cGooding66/cLib/Freecad/Furrel-Green.png

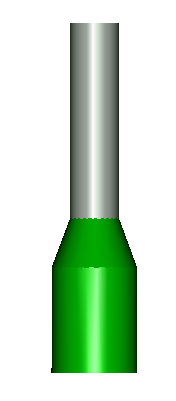
Freecad/Furrel-Green.png
