cGooding66/cLib/3d/D0008A_ASM_cp.step

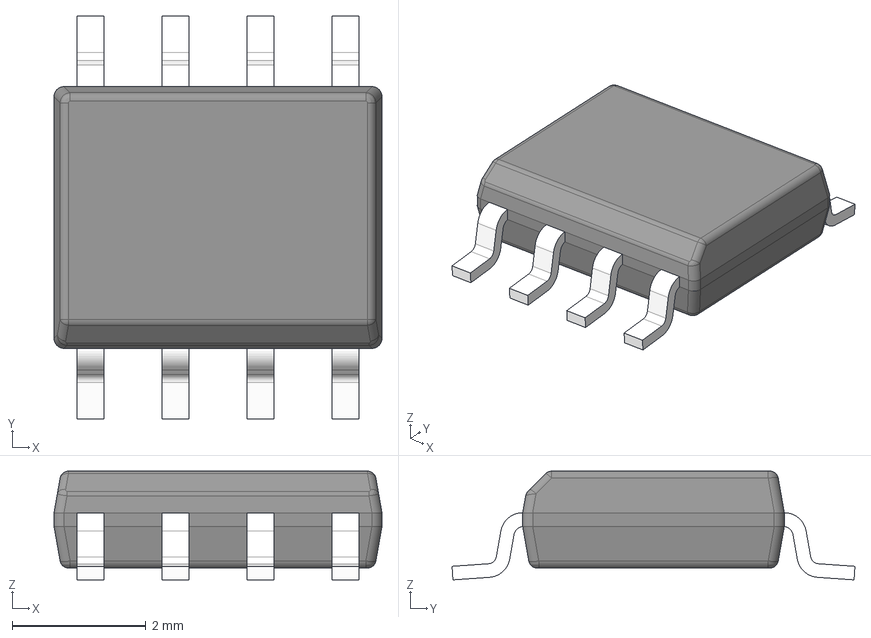
[picture p3: CAD file, 2018-07-28]
3d/D0008A_ASM_cp.step
4.90 x 6.02 x 1.63 mm
