cGooding66/cLib/3d/DBV0006A_ASM_cp.step

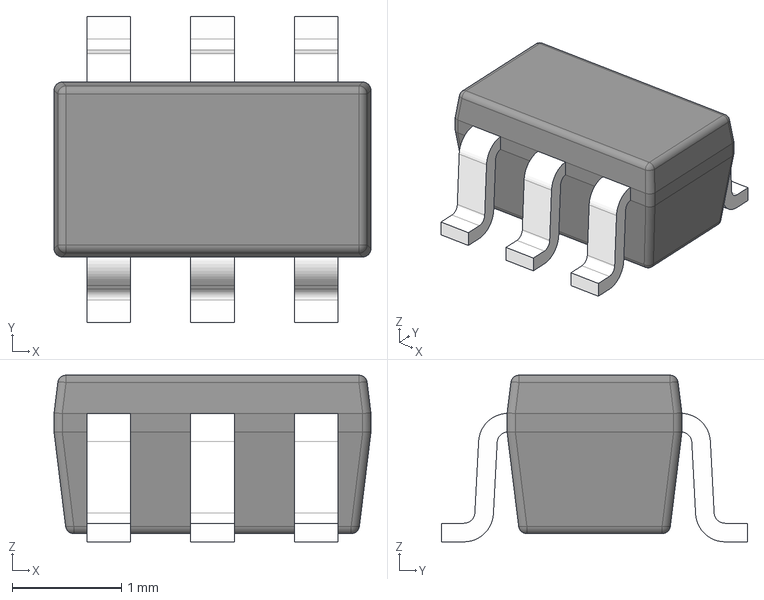
[picture p4: CAD file, 2018-07-28]
3d/DBV0006A_ASM_cp.step
2.90 x 2.80 x 1.53 mm
