cGooding66/cLib/3d/RSE0008A_ASM_cp.step

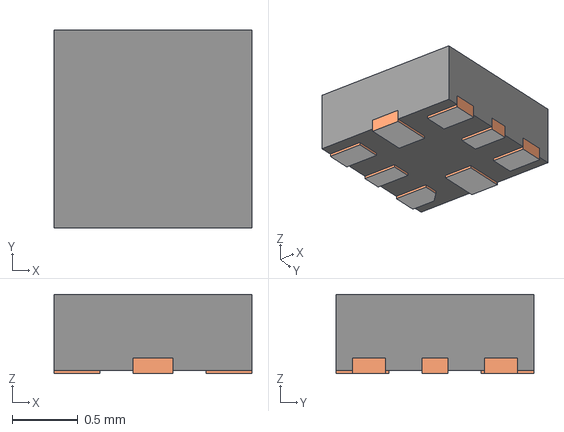
[picture p5: CAD file, 2018-07-28]
3d/RSE0008A_ASM_cp.step
1.50 x 1.50 x 0.6 mm
