cGooding66/cLib/3d/HSON8.step

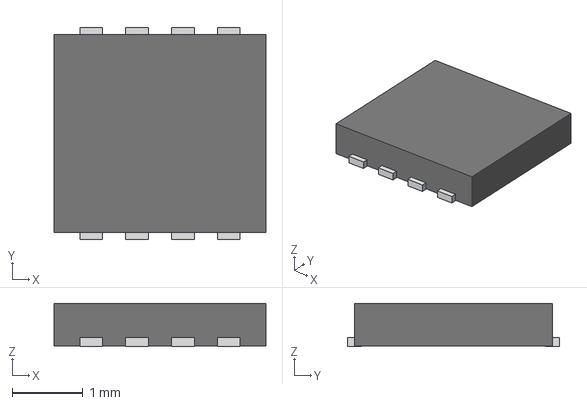
[picture p6: CAD file, 2018-07-28]
3d/HSON8.step
3.00 x 3.00 x 0.61 mm
