cGooding66/cLib/Freecad/Ferrule-Red.step

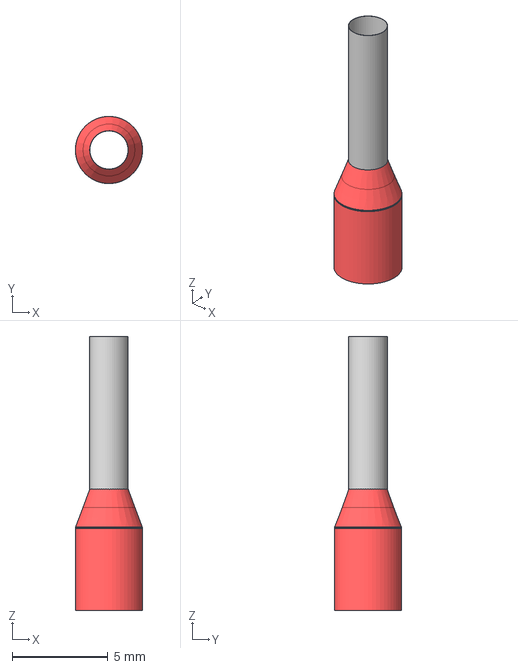
[picture p7: CAD file, 2018-07-28]
Freecad/Ferrule-Red.step
3.51 x 3.51 x 14.3 mm
