cGooding66/cLib/3d/DCJ200-10-A-K1-K.step

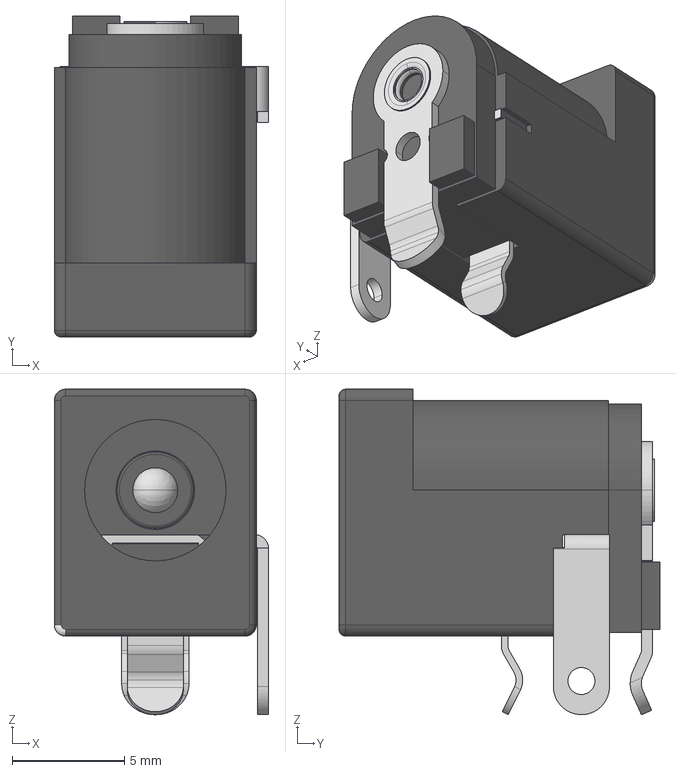
[picture p8: CAD file, 2018-07-28]
3d/DCJ200-10-A-K1-K.step
9.55 x 14.3 x 14.5 mm
