cGooding66/cLib/3d/DO219AB.step

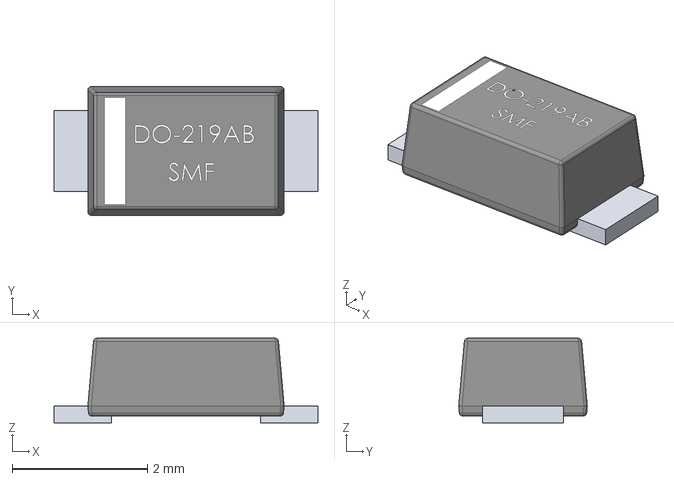
[picture p9: CAD file, 2018-07-28]
3d/DO219AB.step
3.90 x 1.90 x 1.25 mm
