cGooding66/cLib/Freecad/Amber-LED.fcstd

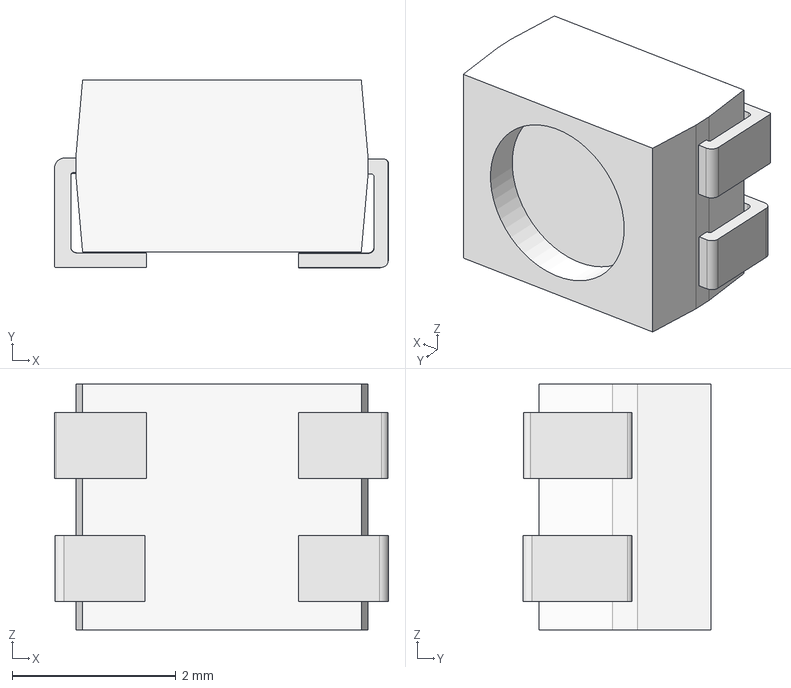
[picture p10: CAD file, 2018-07-28]
Freecad/Amber-LED.fcstd
4.07 x 2.29 x 3.00 mm
