cGooding66/cLib/3d/QSOP16-1.step

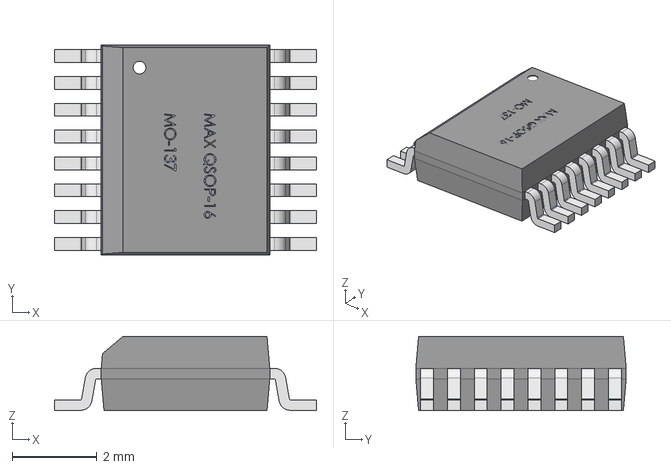
[picture p11: CAD file, 2018-07-28]
3d/QSOP16-1.step
6.20 x 4.98 x 1.76 mm
