cGooding66/cLib/Freecad/LED-PLCC4.stp

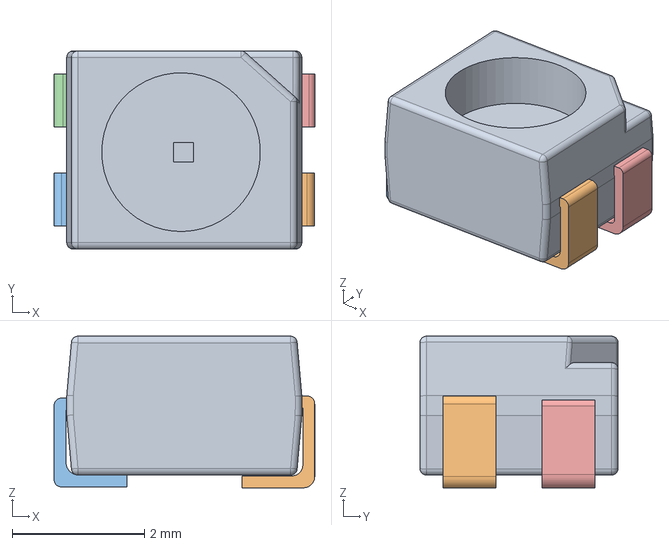
[picture p12: CAD file, 2018-07-28]
Freecad/LED-PLCC4.stp
3.95 x 3.00 x 2.29 mm
