cGooding66/cLib/3d/TQFP_48.step

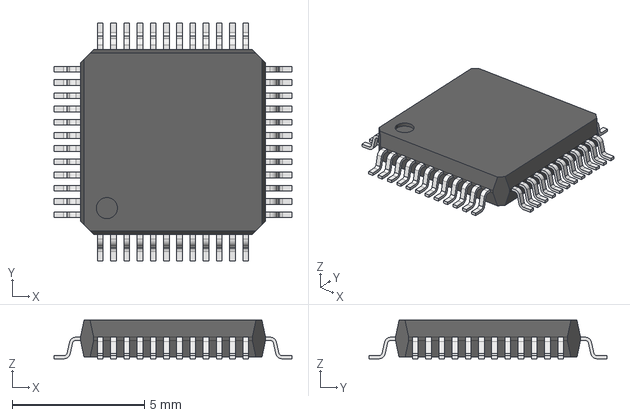
[picture p13: CAD file, 2018-07-28]
3d/TQFP_48.step
9.00 x 9.00 x 1.46 mm
