cGooding66/cLib/3d/mcv_1.5-8-gf-3.5.step

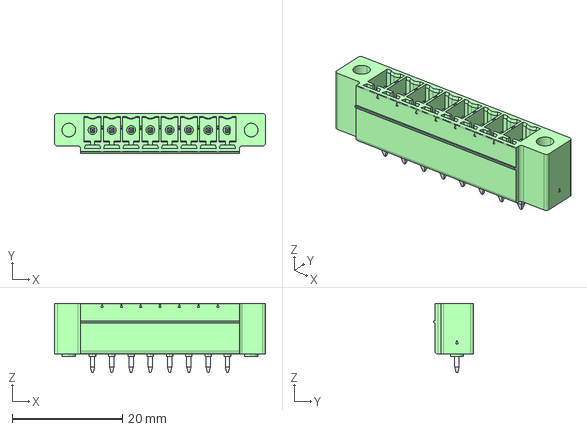
[picture p14: CAD file, 2018-07-28]
3d/mcv_1.5-8-gf-3.5.step
38.3 x 7.25 x 12.6 mm
