cGooding66/cLib/Freecad/Cable.fcstd

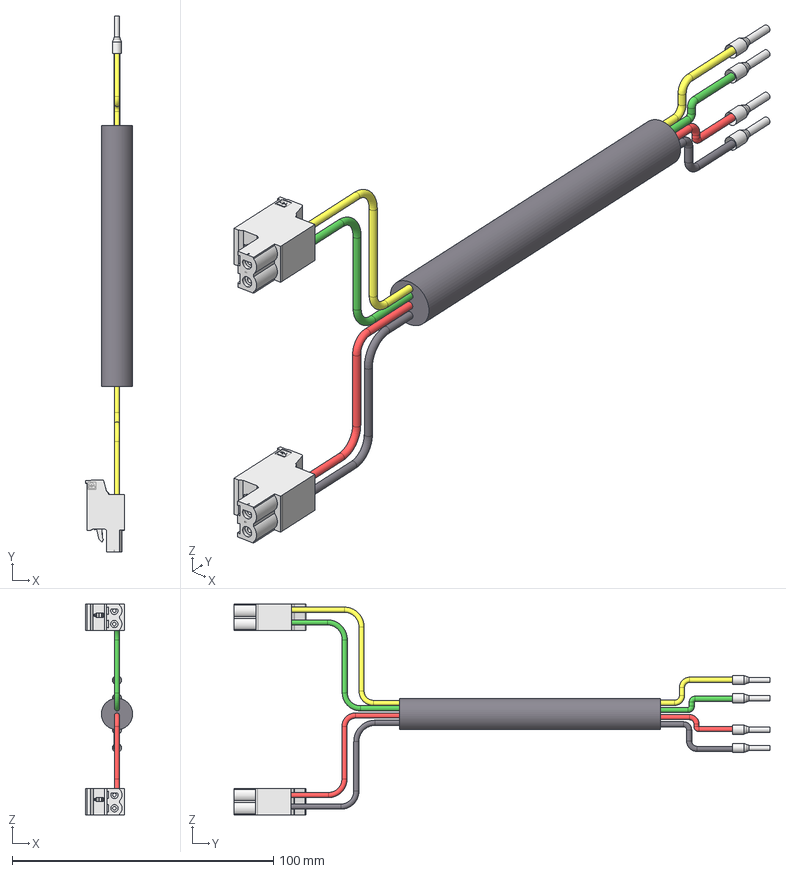
[picture p16: CAD file, 2018-07-28]
Freecad/Cable.fcstd
18.1 x 205.2 x 80.7 mm
Cable
Phoenix
Black-Ferrule
Green-Ferrule
Red-Ferrule
Yellow-Ferrule
Phoenix001
