cGooding66/cLib/Freecad/Ferrule.fcstd

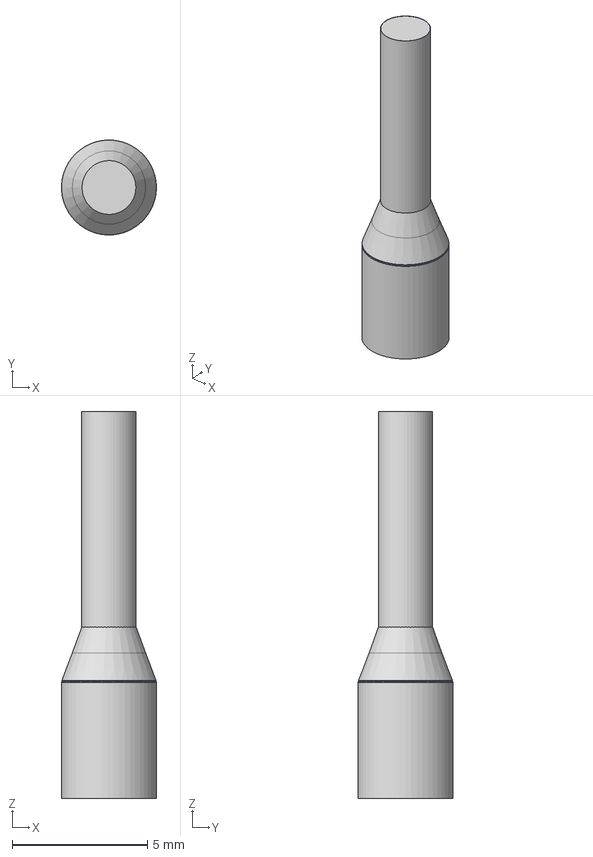
[picture p17: CAD file, 2018-07-28]
Freecad/Ferrule.fcstd
3.51 x 3.51 x 14.3 mm
