cGooding66/cLib/3d/VHR-2N.STEP

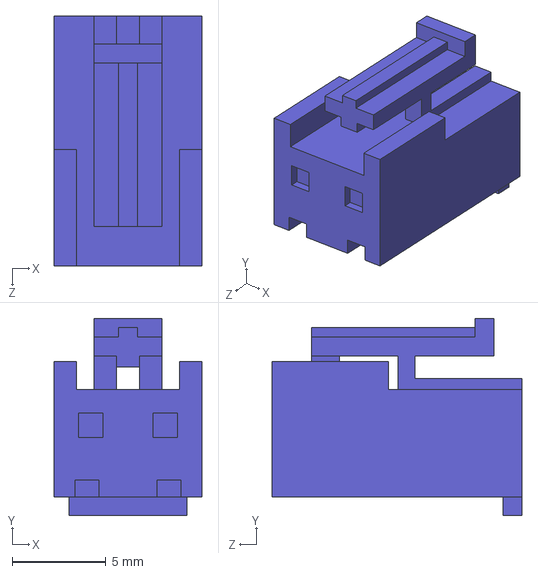
[picture p18: CAD file, 2018-07-28]
3d/VHR-2N.STEP
7.86 x 10.5 x 13.3 mm
