cGooding66/cLib/3d/9GTH935.step

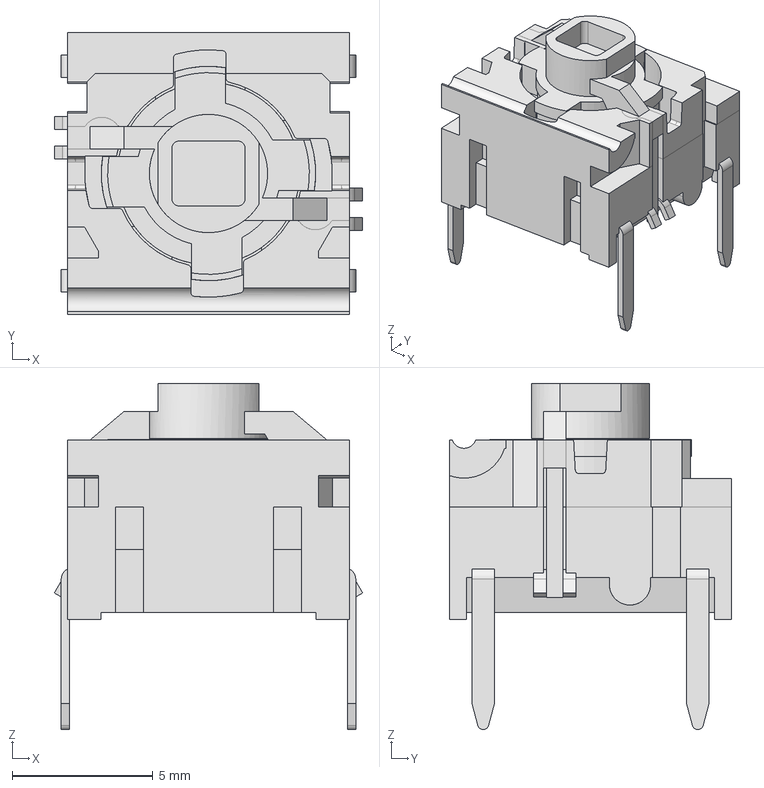
[picture p19: CAD file, 2018-07-28]
3d/9GTH935.step
10.9 x 10.0 x 12.3 mm
