cGooding66/cLib/3d/LED_RED_PLCC4.step

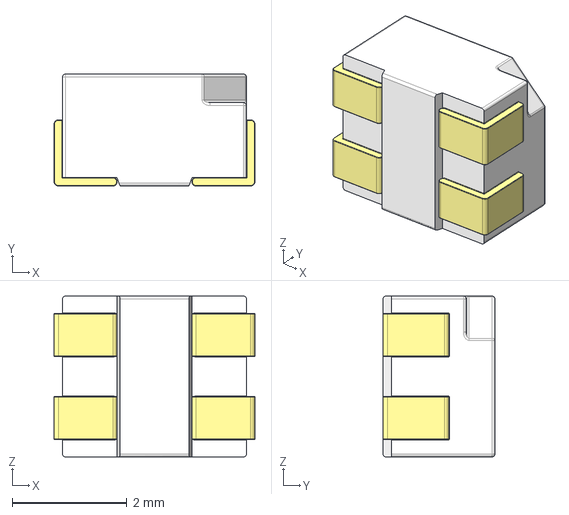
[picture p20: CAD file, 2018-07-28]
3d/LED_RED_PLCC4.step
3.50 x 1.95 x 2.80 mm
