cGooding66/cLib/3d/User Library-tsx-3225-1.stl

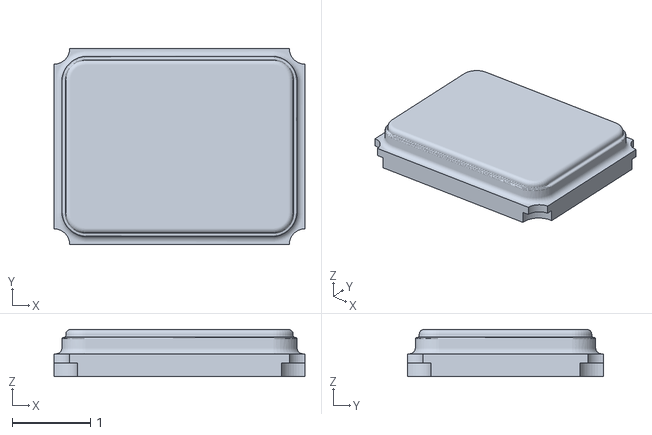
[picture p21: CAD file, 2018-07-28]
3d/User Library-tsx-3225-1.stl
3.20 x 2.50 x 0.6
