cGooding66/cLib/3d/EEEFKC151XAP.step

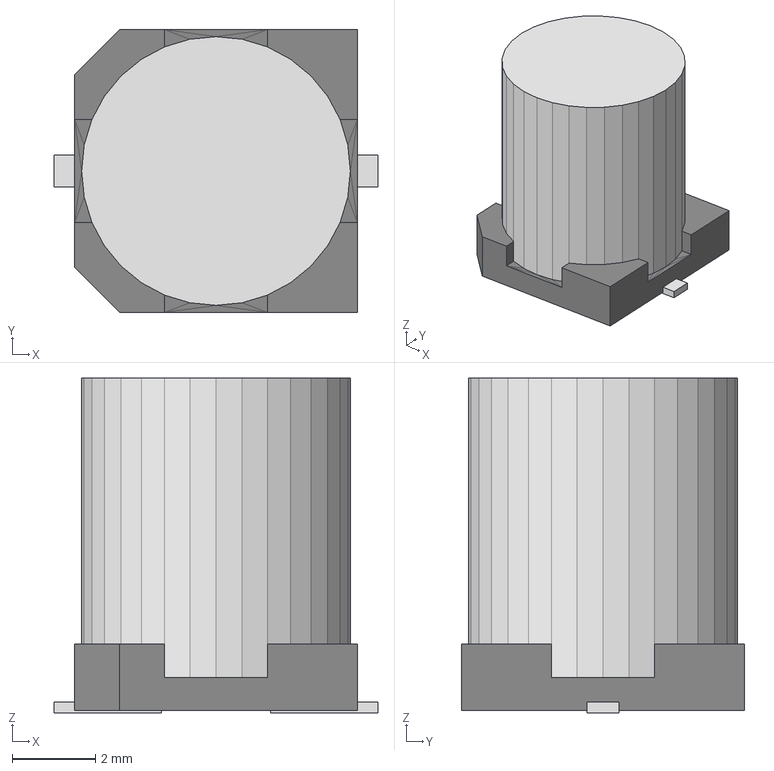
[picture p22: CAD file, 2018-07-28]
3d/EEEFKC151XAP.step
7.80 x 6.81 x 8.05 mm
