cGooding66/cLib/3d/ABS07.step

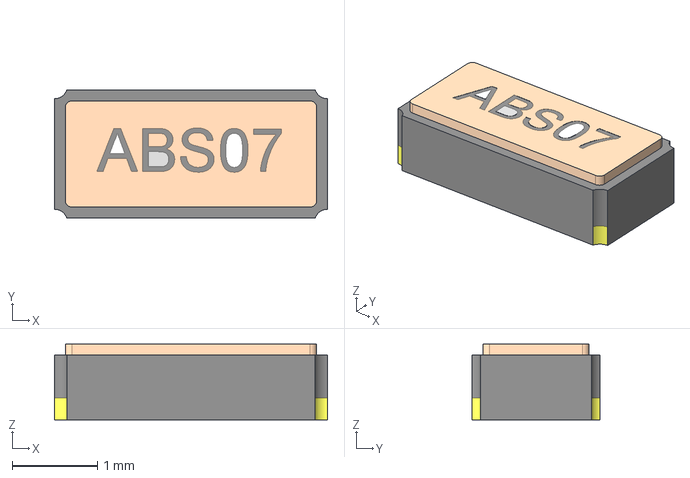
[picture p23: CAD file, 2018-07-28]
3d/ABS07.step
3.20 x 1.50 x 0.889 mm
