cGooding66/cLib/3d/DIODE_SMA.step

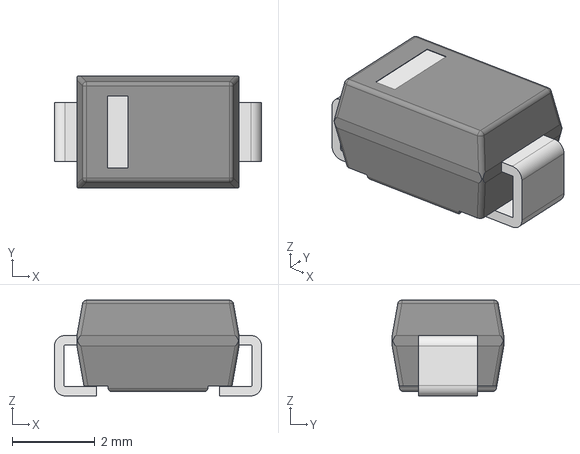
[picture p24: CAD file, 2018-07-28]
3d/DIODE_SMA.step
5.00 x 2.70 x 2.31 mm
