cGooding66/cLib/3d/B3B-PH-K-S.step

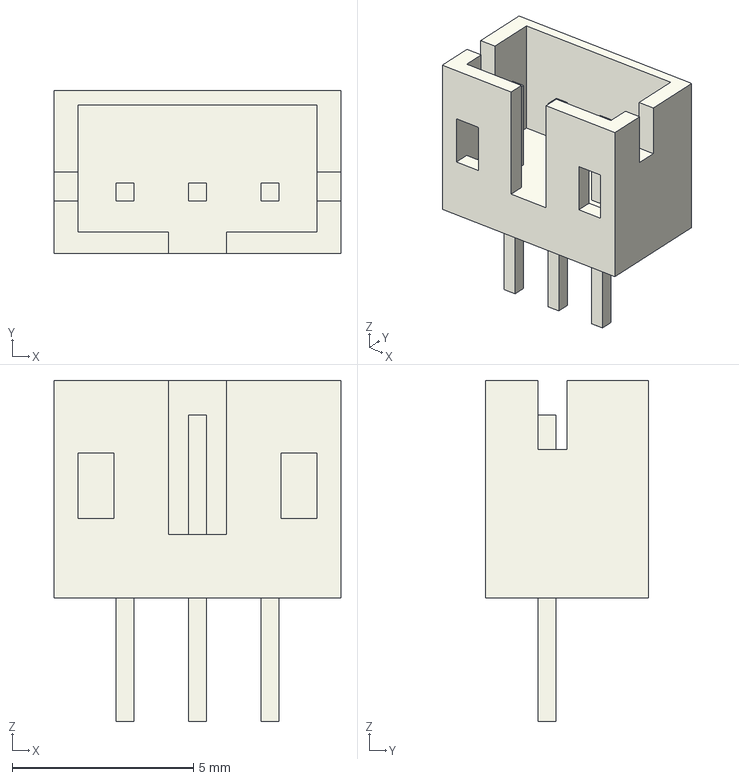
[picture p25: CAD file, 2018-07-28]
3d/B3B-PH-K-S.step
7.90 x 4.50 x 9.40 mm
