cGooding66/cLib/3d/User Library-TSSOP20.stl

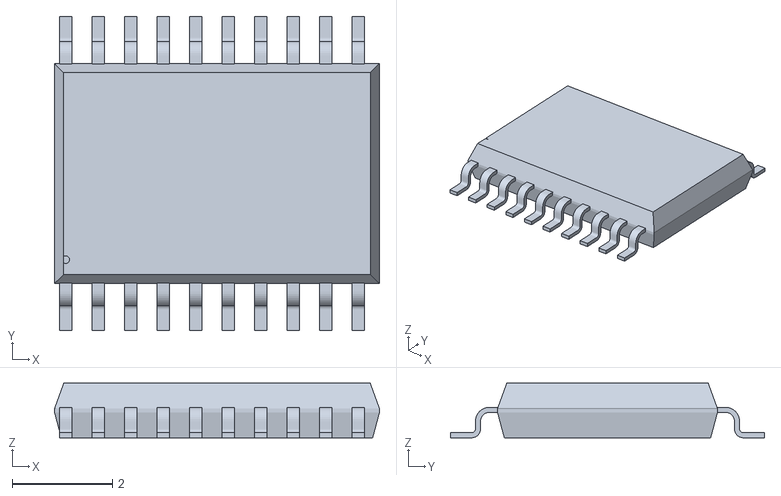
[picture p26: CAD file, 2018-07-28]
3d/User Library-TSSOP20.stl
6.50 x 6.28 x 1.09
