cGooding66/cLib/3d/QFN24.step

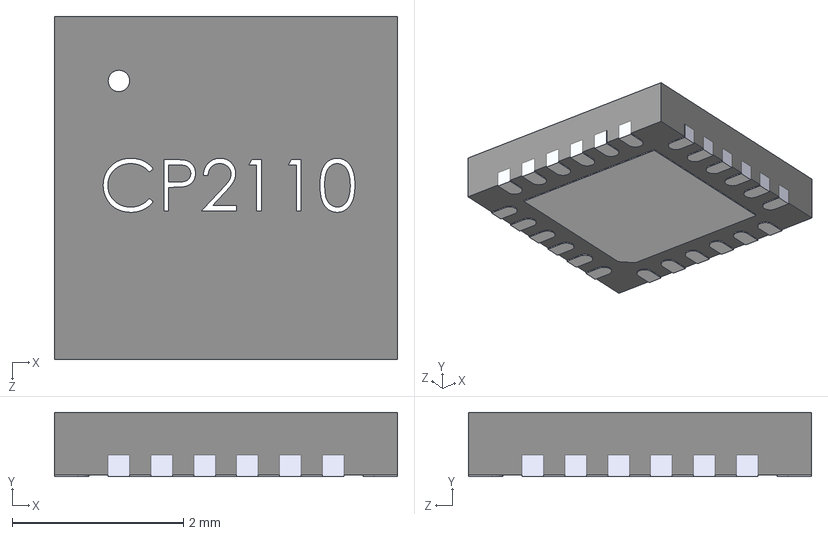
[picture p27: CAD file, 2018-07-28]
3d/QFN24.step
4.00 x 0.75 x 4.00 mm
