cGooding66/cLib/3d/B2P-VH-B.STEP

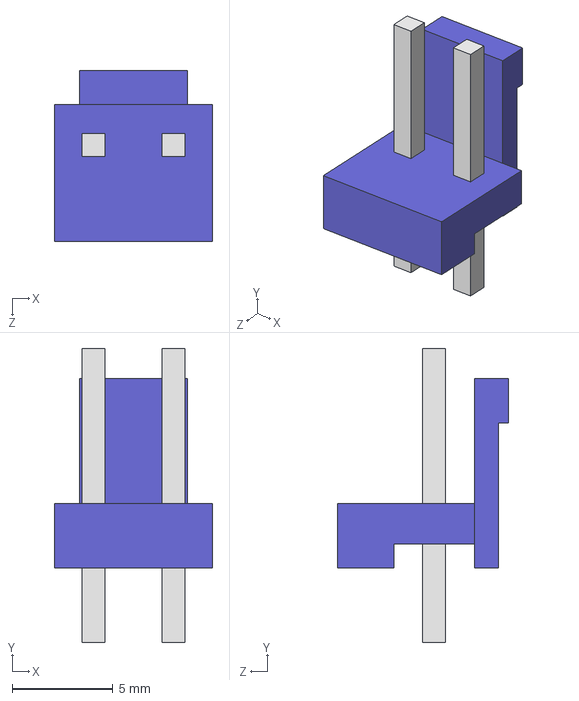
[picture p28: CAD file, 2018-07-28]
3d/B2P-VH-B.STEP
7.86 x 14.6 x 8.50 mm
