cGooding66/cLib/3d/mcv_1.5-5-gf-3.5.step

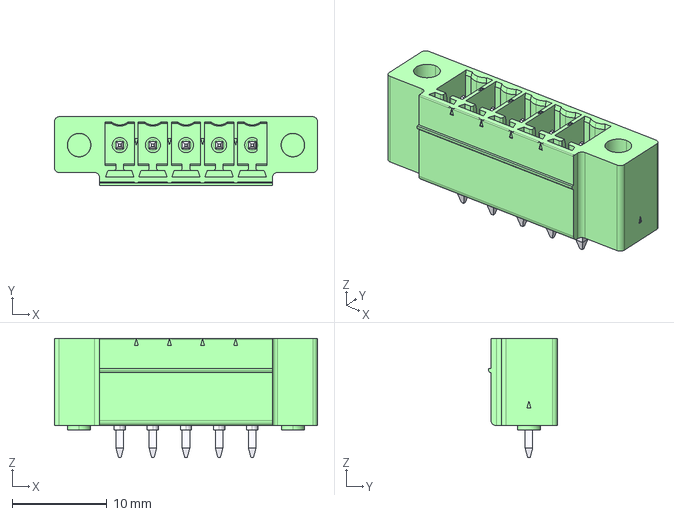
[picture p29: CAD file, 2018-07-28]
3d/mcv_1.5-5-gf-3.5.step
27.8 x 7.25 x 12.6 mm
