cGooding66/cLib/3d/TSW-110-14-L-D-LL.step

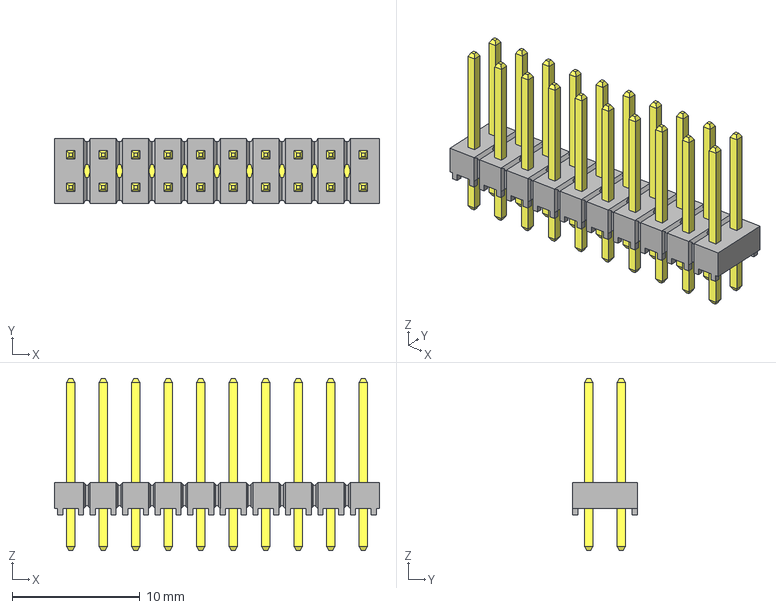
[picture p30: CAD file, 2018-07-28]
3d/TSW-110-14-L-D-LL.step
25.4 x 5.08 x 13.5 mm
