cGooding66/cLib/3d/SRN6045_Series.step

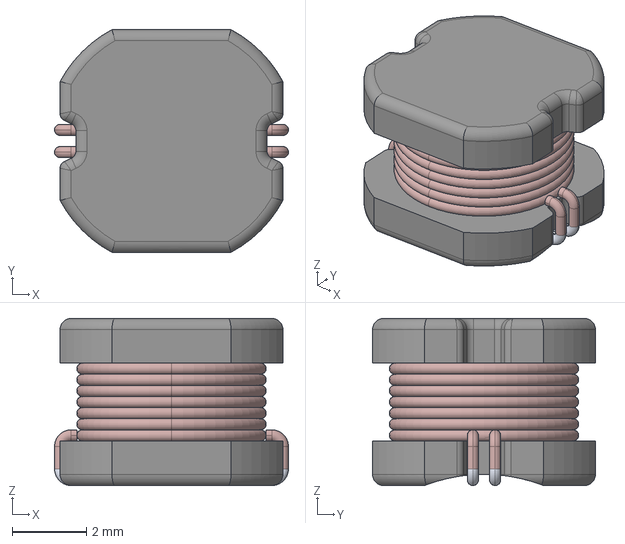
[picture p31: CAD file, 2018-07-28]
3d/SRN6045_Series.step
6.30 x 6.00 x 4.50 mm
