cGooding66/cLib/3d/SM08B-NSHSS.step

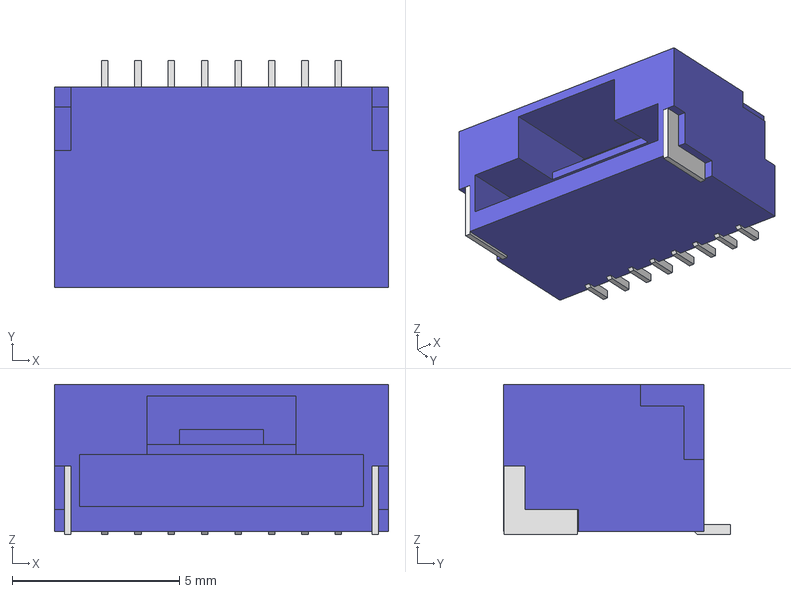
[picture p32: CAD file, 2018-07-28]
3d/SM08B-NSHSS.step
10.0 x 6.80 x 4.50 mm
