cGooding66/cLib/3d/TSOP-6.step

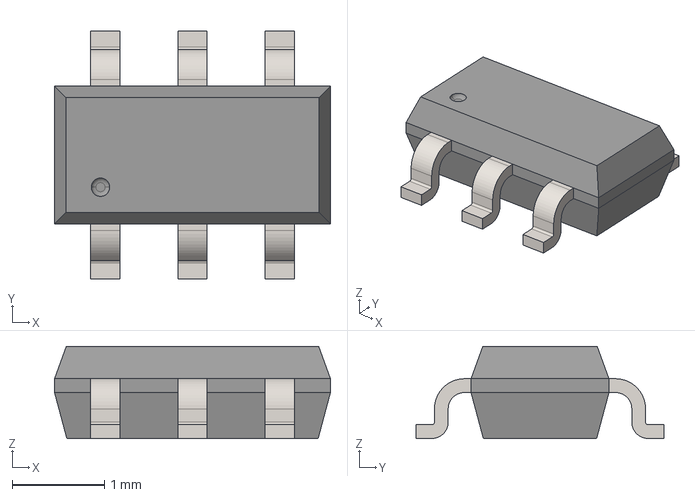
[picture p33: CAD file, 2018-07-28]
3d/TSOP-6.step
3.00 x 2.70 x 1.00 mm
