cGooding66/cLib/3d/TQFP64-10x10x1.step

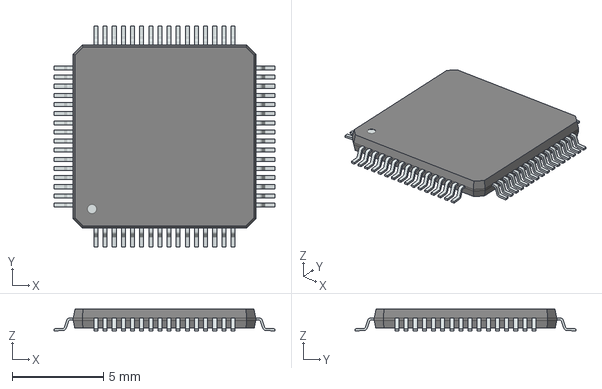
[picture p34: CAD file, 2018-07-28]
3d/TQFP64-10x10x1.step
12.1 x 12.1 x 1.20 mm
