cGooding66/cLib/3d/QFN16_4x4x0.9.step

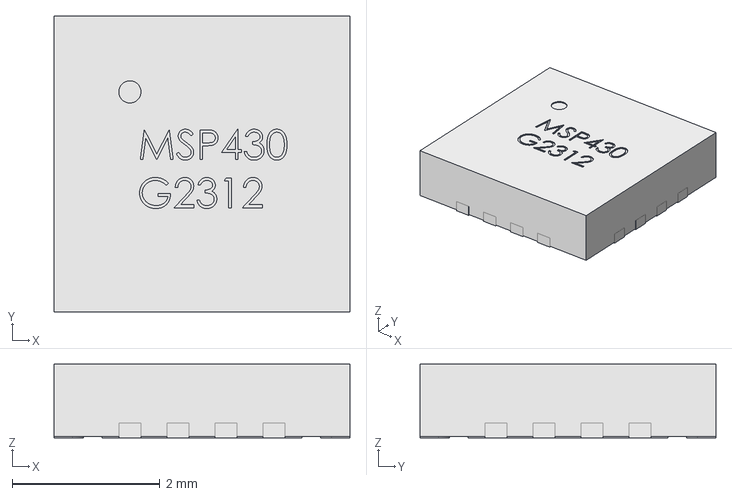
[picture p35: CAD file, 2018-07-28]
3d/QFN16_4x4x0.9.step
4.00 x 4.00 x 1.00 mm
