cGooding66/cLib/3d/BHD-2.step

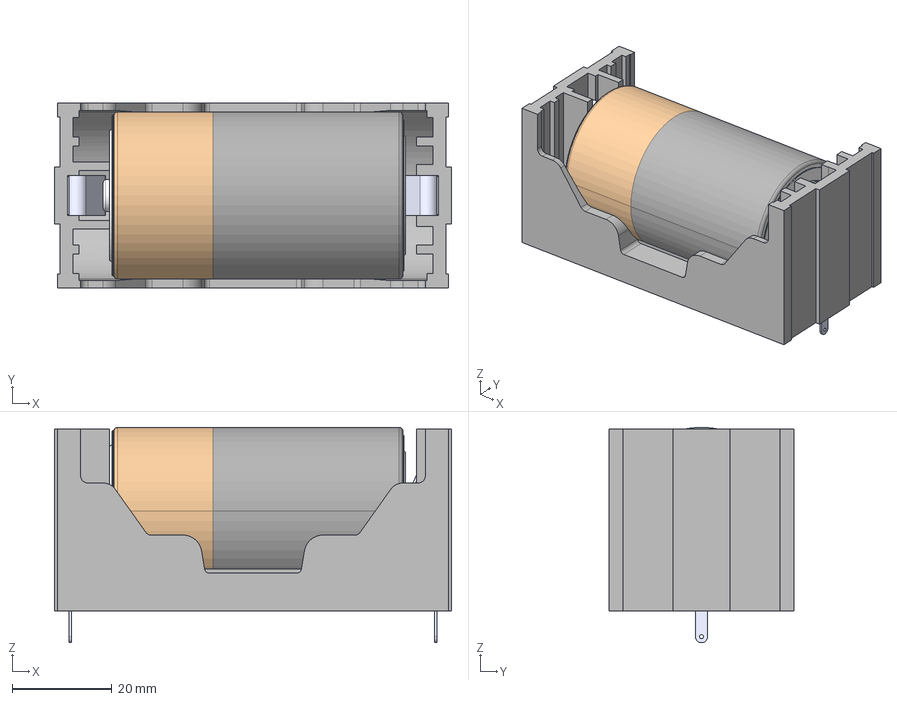
[picture p36: CAD file, 2018-07-28]
3d/BHD-2.step
79.4 x 37.1 x 43.1 mm
