cGooding66/cLib/3d/FTSH-105-01-F-DV.stl

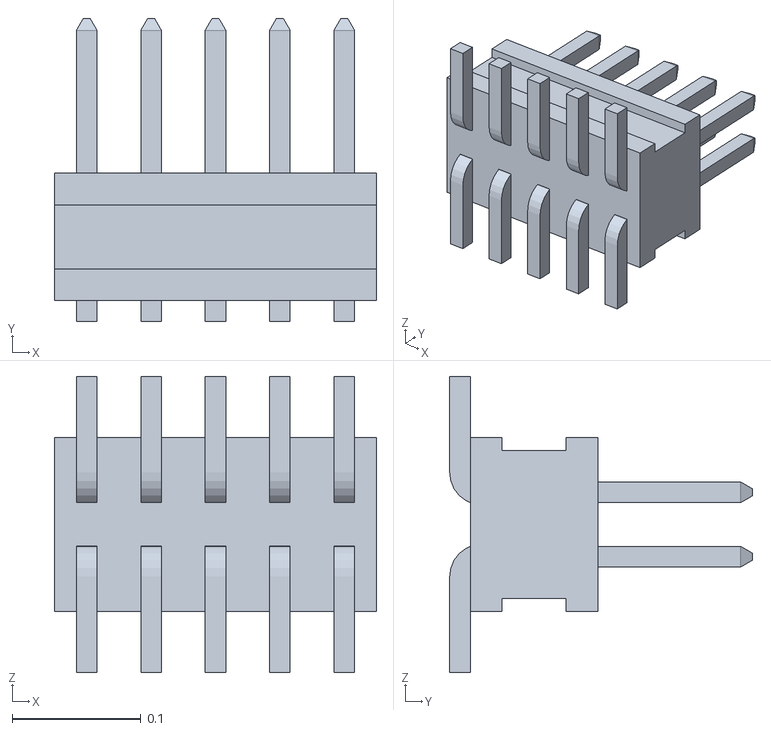
[picture p37: CAD file, 2018-07-28]
3d/FTSH-105-01-F-DV.stl
0.25 x 0.235 x 0.23
