cGooding66/cLib/3d/mcv1.5-2-g_3.5.step

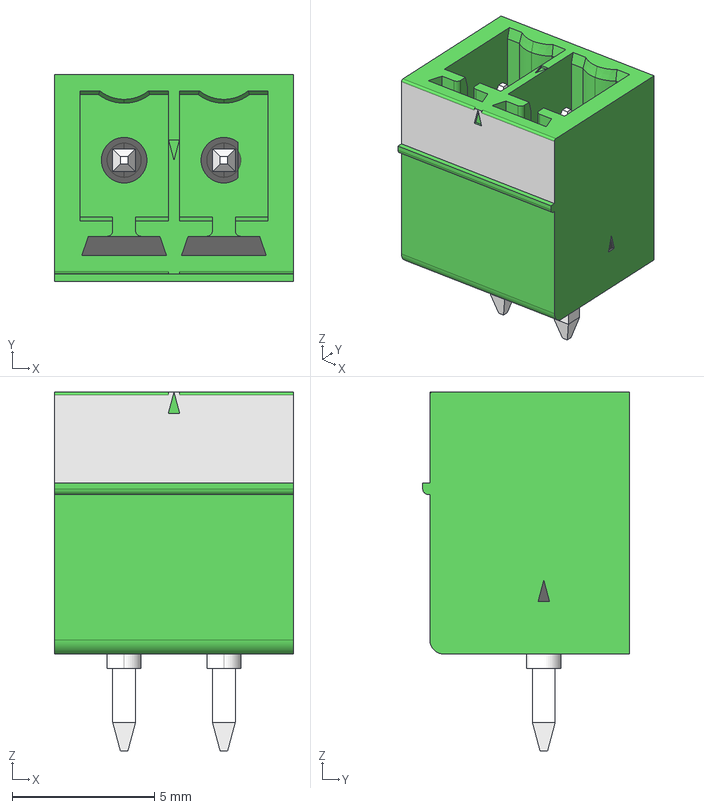
[picture p38: CAD file, 2018-07-28]
3d/mcv1.5-2-g_3.5.step
8.40 x 7.25 x 12.6 mm
