cGooding66/cLib/3d/sot235.STEP

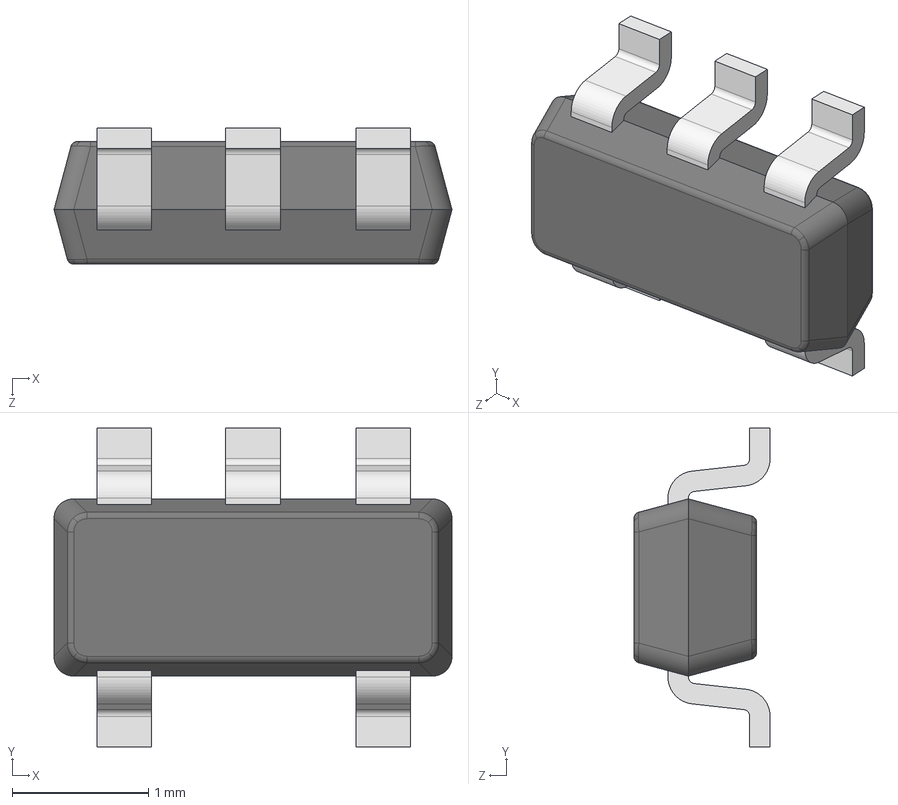
[picture p40: CAD file, 2018-07-28]
3d/sot235.STEP
2.92 x 2.34 x 1.00 mm
