cGooding66/cLib/3d/Terminal strip.step

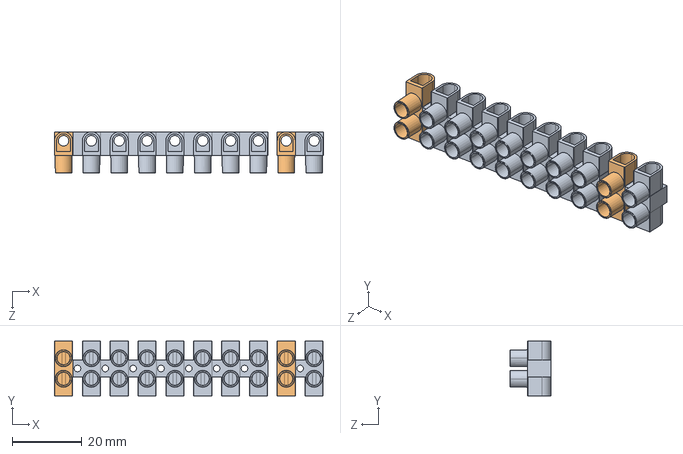
[picture p41: CAD file, 2018-07-28]
3d/Terminal strip.step
77.3 x 15.8 x 11.9 mm
