cGooding66/cLib/3d/MLE-106-01-G-DV-A.stl

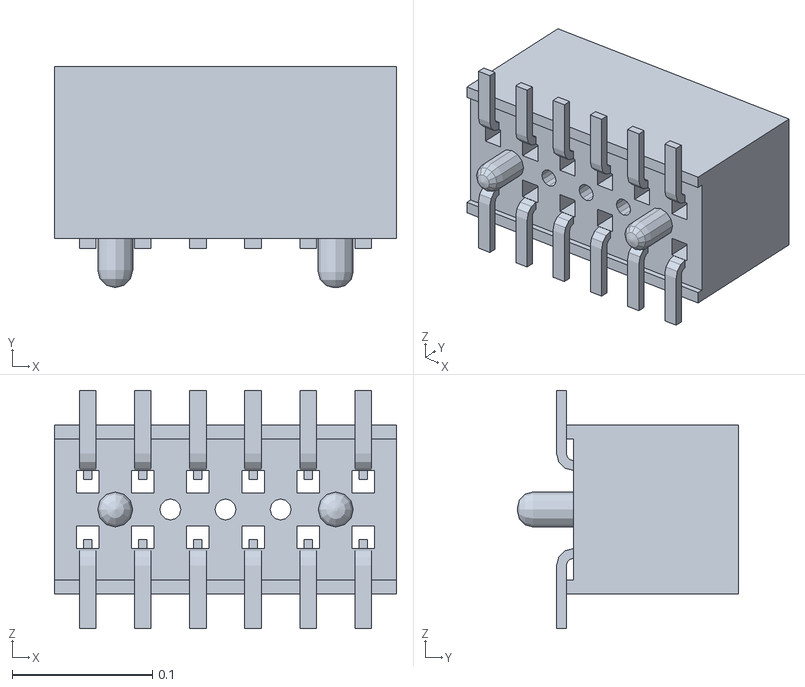
[picture p42: CAD file, 2018-07-28]
3d/MLE-106-01-G-DV-A.stl
0.244 x 0.158 x 0.17
