cGooding66/cLib/3d/XSON8(3x2).step

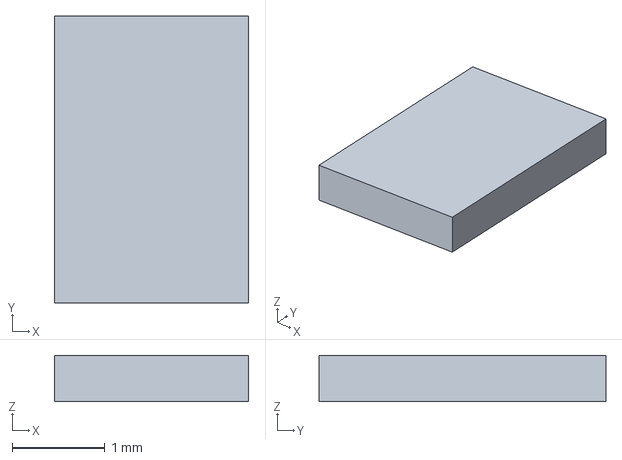
[picture p43: CAD file, 2018-07-28]
3d/XSON8(3x2).step
2.10 x 3.10 x 0.5 mm
