cGooding66/cLib/3d/LED3MM-THT.step

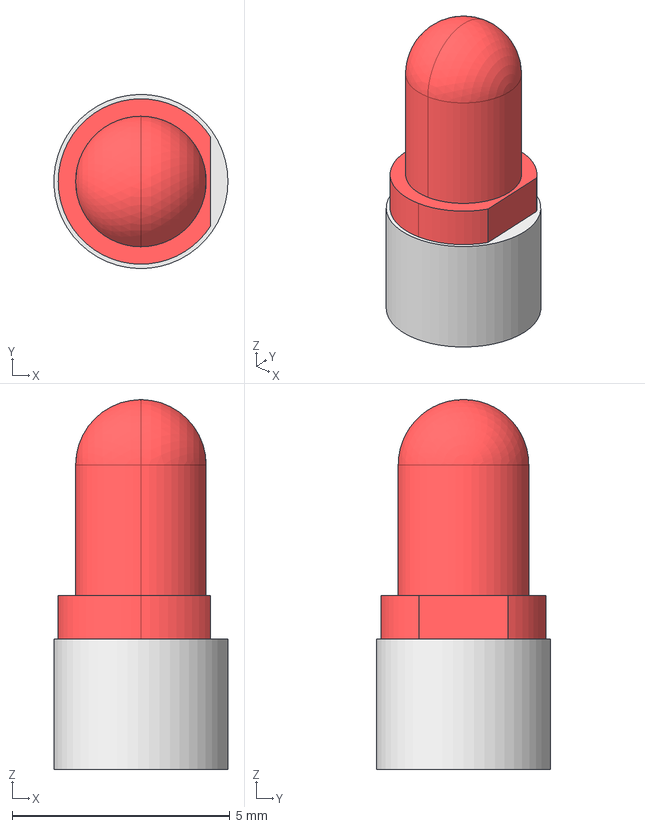
[picture p44: CAD file, 2018-07-28]
3d/LED3MM-THT.step
4.00 x 4.00 x 8.50 mm
