cGooding66/cLib/3d/MLE-06.step

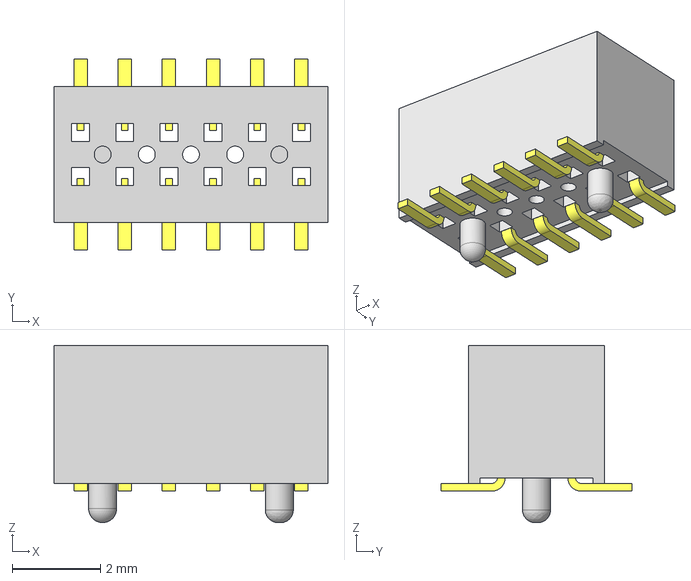
[picture p45: CAD file, 2018-07-28]
3d/MLE-06.step
6.20 x 4.32 x 4.01 mm
