cGooding66/cLib/3d/TSSOP-14.step

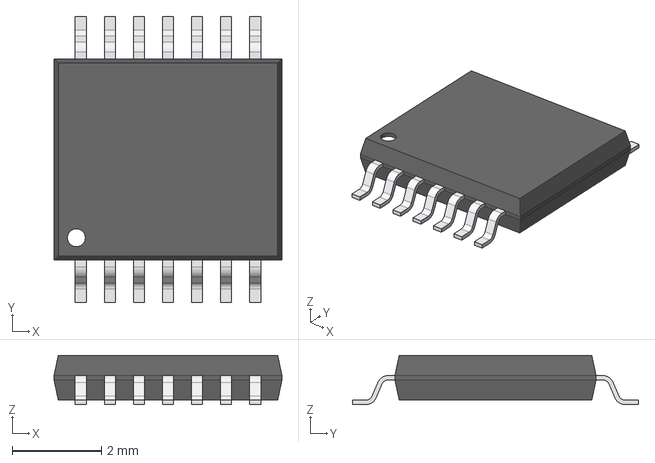
[picture p47: CAD file, 2018-07-28]
3d/TSSOP-14.step
5.10 x 6.40 x 1.10 mm
