cGooding66/cLib/3d/qfn16-4X4-ep.step

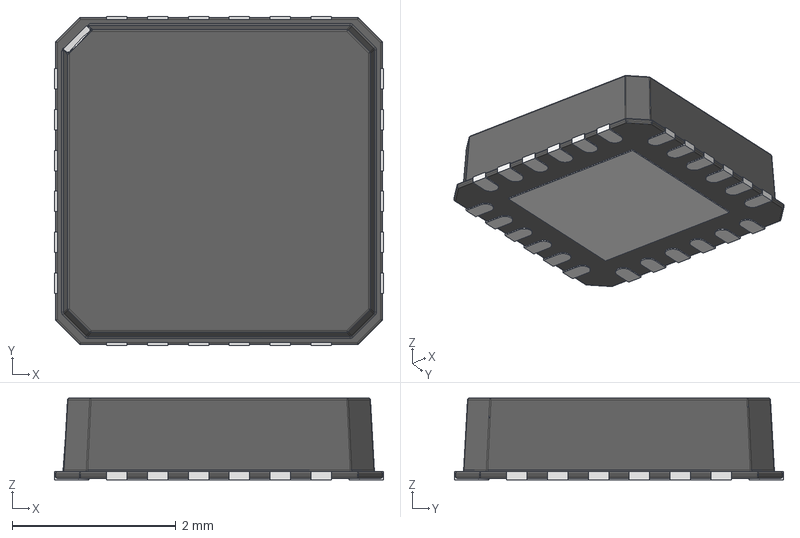
[picture p48: CAD file, 2018-07-28]
3d/qfn16-4X4-ep.step
4.02 x 4.02 x 1.00 mm
