cGooding66/cLib/3d/UTS714D18S32_sp.step

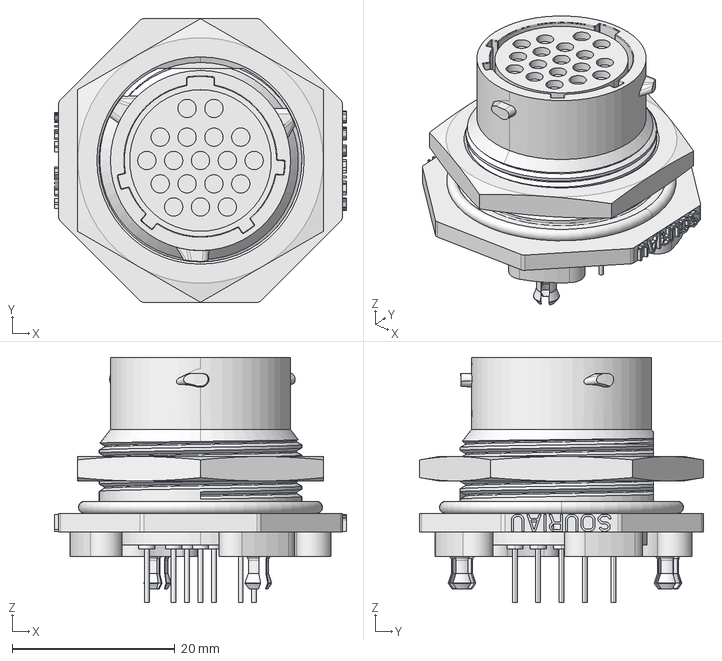
[picture p49: CAD file, 2018-07-28]
3d/UTS714D18S32_sp.step
35.9 x 34.9 x 30.2 mm
