cGooding66/cLib/3d/Programmer_Tray.stl

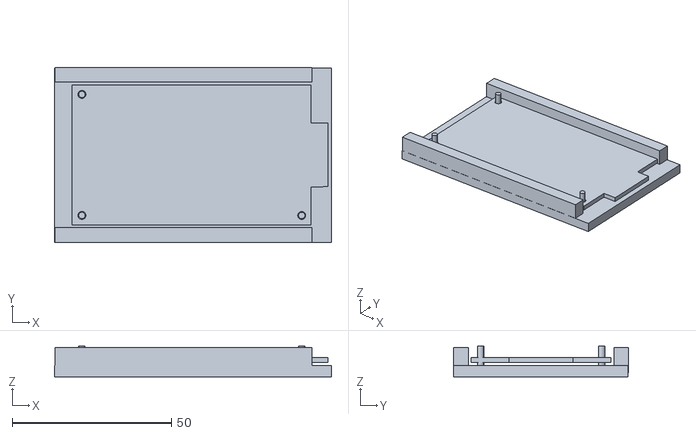
[picture p50: CAD file, 2018-07-28]
3d/Programmer_Tray.stl
86.9 x 55.0 x 9.59
