cGooding66/cLib/3d/SOIC8_5x5.step

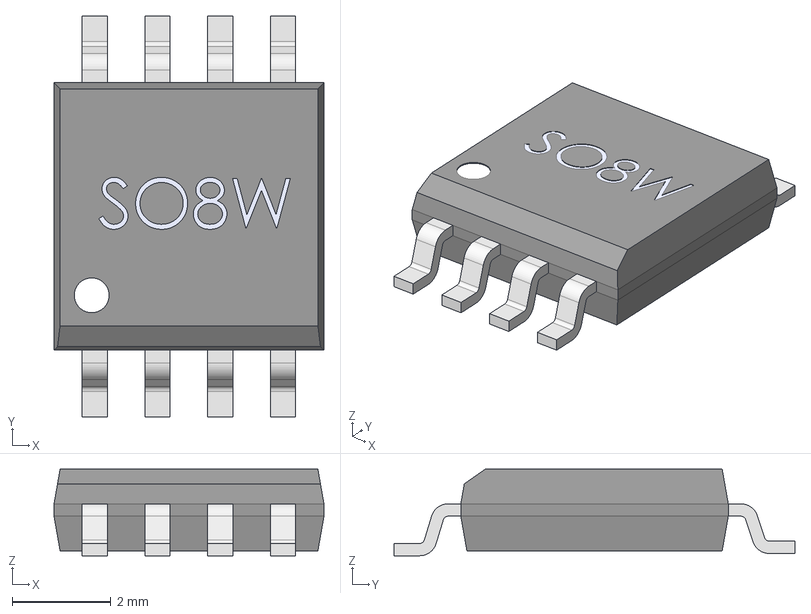
[picture p51: CAD file, 2018-07-28]
3d/SOIC8_5x5.step
5.46 x 8.10 x 1.75 mm
