cGooding66/cLib/3d/ECA-1HM331.step

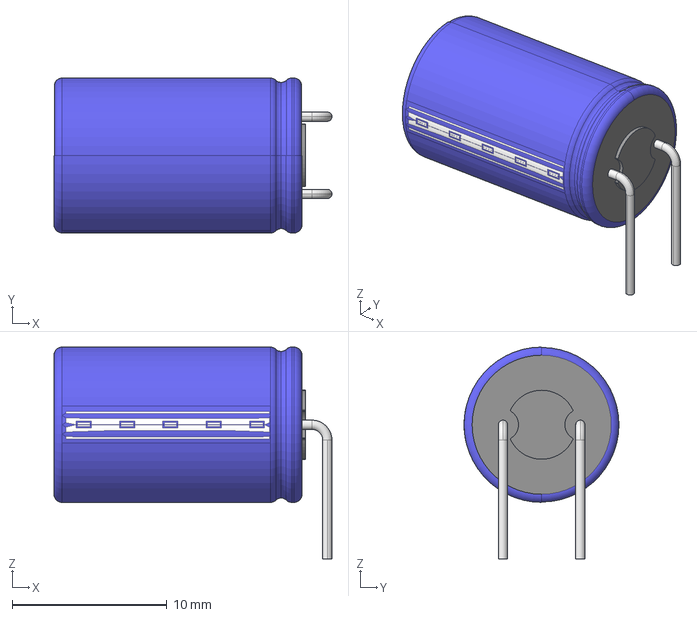
[picture p52: CAD file, 2018-07-28]
3d/ECA-1HM331.step
18.0 x 10.0 x 13.7 mm
