cGooding66/cLib/3d/A750KK477M1AAAE016.step

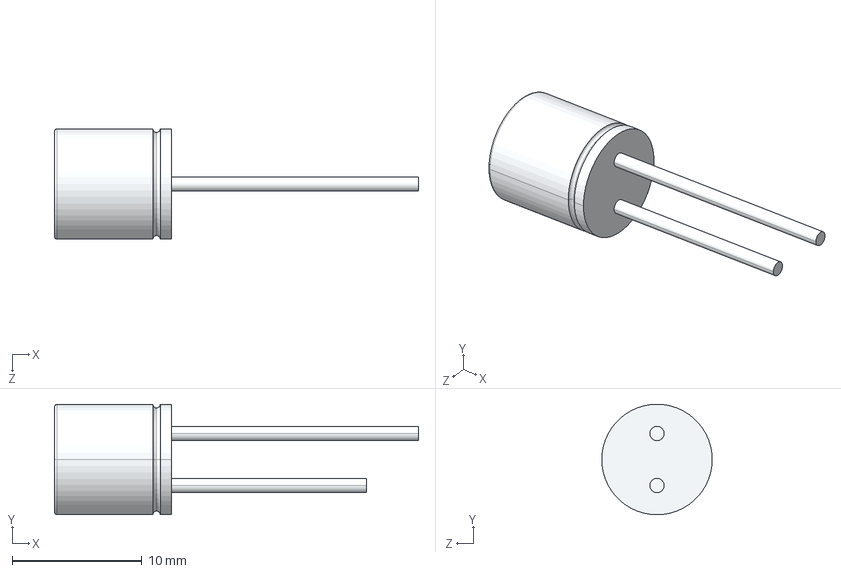
[picture p53: CAD file, 2018-07-28]
3d/A750KK477M1AAAE016.step
28.0 x 8.50 x 8.50 mm
