cGooding66/cLib/3d/Red-LED_PLCC4.step

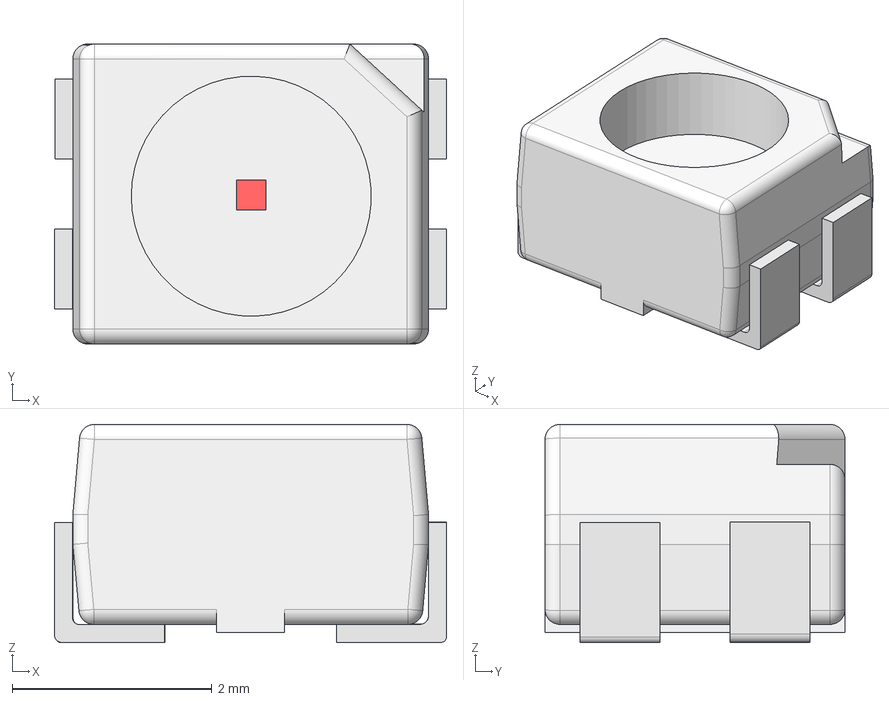
[picture p54: CAD file, 2018-07-28]
3d/Red-LED_PLCC4.step
3.92 x 3.00 x 2.18 mm
