cGooding66/cLib/3d/MSOP-16.step

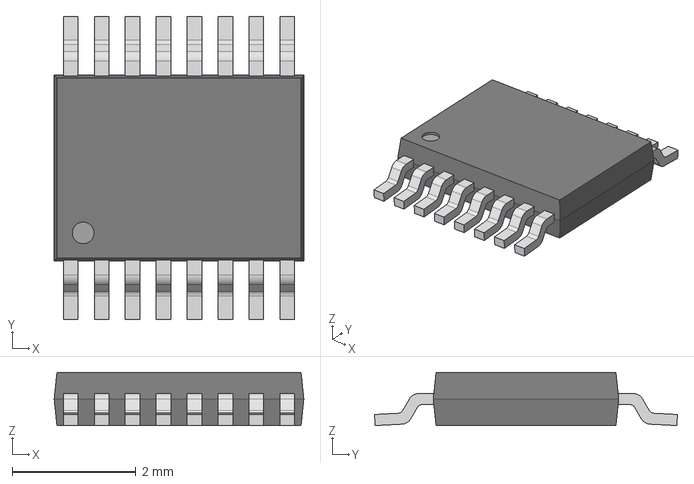
[picture p55: CAD file, 2018-07-28]
3d/MSOP-16.step
4.04 x 4.90 x 0.86 mm
