cGooding66/cLib/3d/MW-06-03-G-D-185-075-A.step

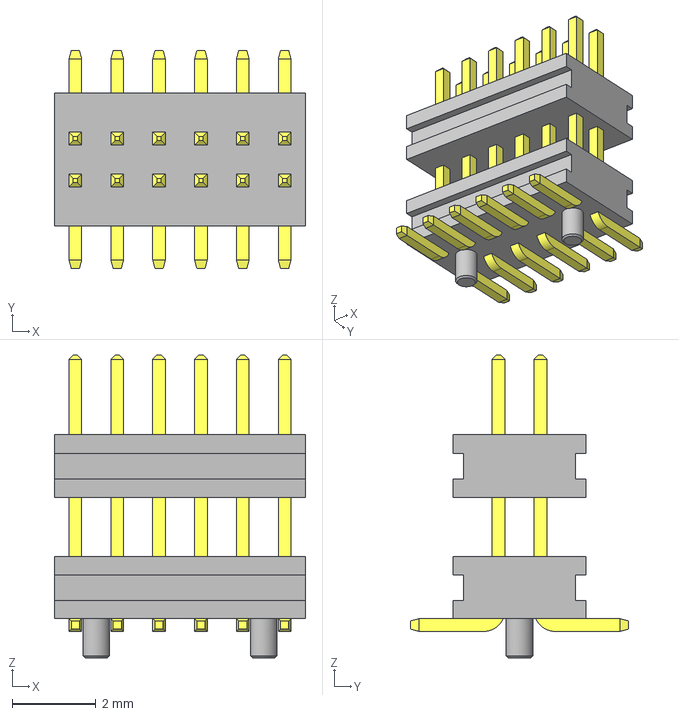
[picture p56: CAD file, 2018-07-28]
3d/MW-06-03-G-D-185-075-A.step
6.00 x 5.21 x 7.24 mm
