cGooding66/cLib/3d/KPTB-1615ESGC.step

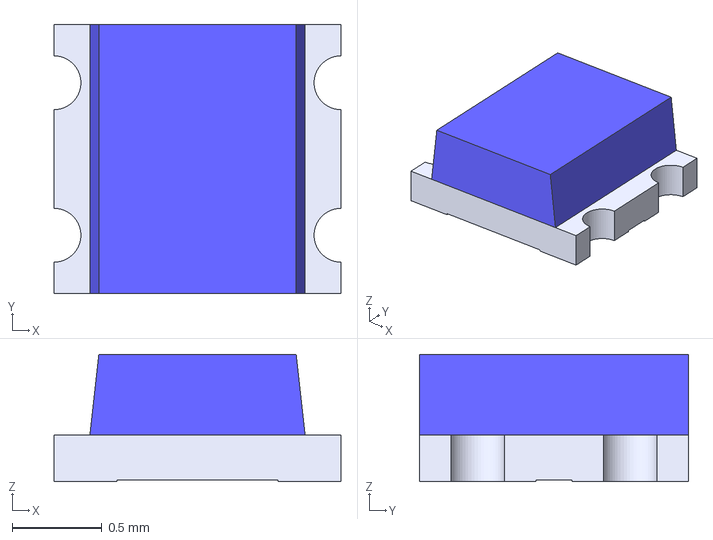
[picture p57: CAD file, 2018-07-28]
3d/KPTB-1615ESGC.step
1.60 x 1.50 x 0.71 mm
