cGooding66/cLib/3d/TSSOP-16.step

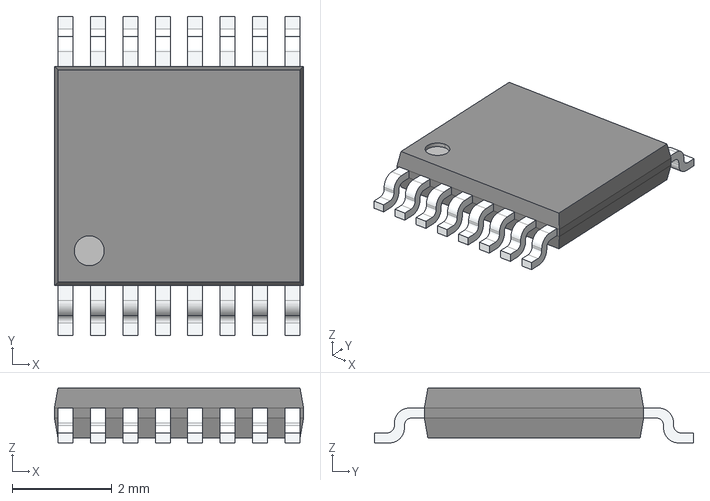
[picture p58: CAD file, 2018-07-28]
3d/TSSOP-16.step
5.00 x 6.40 x 1.10 mm
