cGooding66/cLib/3d/User Library-TSSOP24_(JEDEC_MO-153).step

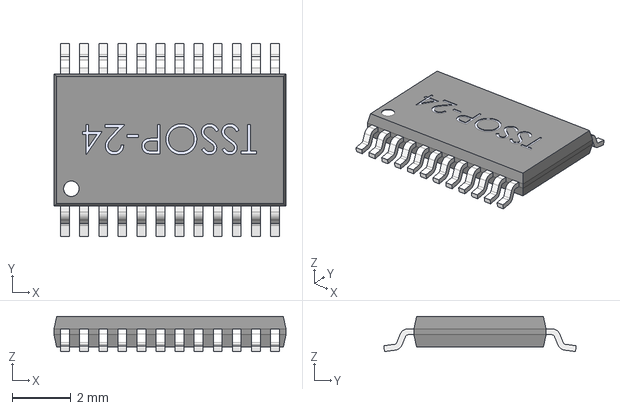
[picture p59: CAD file, 2018-07-28]
3d/User Library-TSSOP24_(JEDEC_MO-153).step
7.90 x 6.56 x 1.20 mm
