cGooding66/cLib/3d/SRF2012A.step

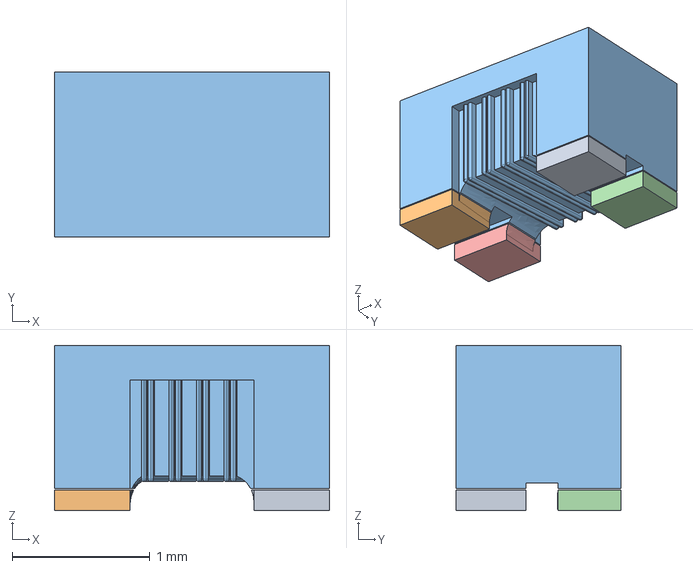
[picture p60: CAD file, 2018-07-28]
3d/SRF2012A.step
2.00 x 1.20 x 1.20 mm
