cGooding66/cLib/3d/User Library-QFN48_7x7.stl

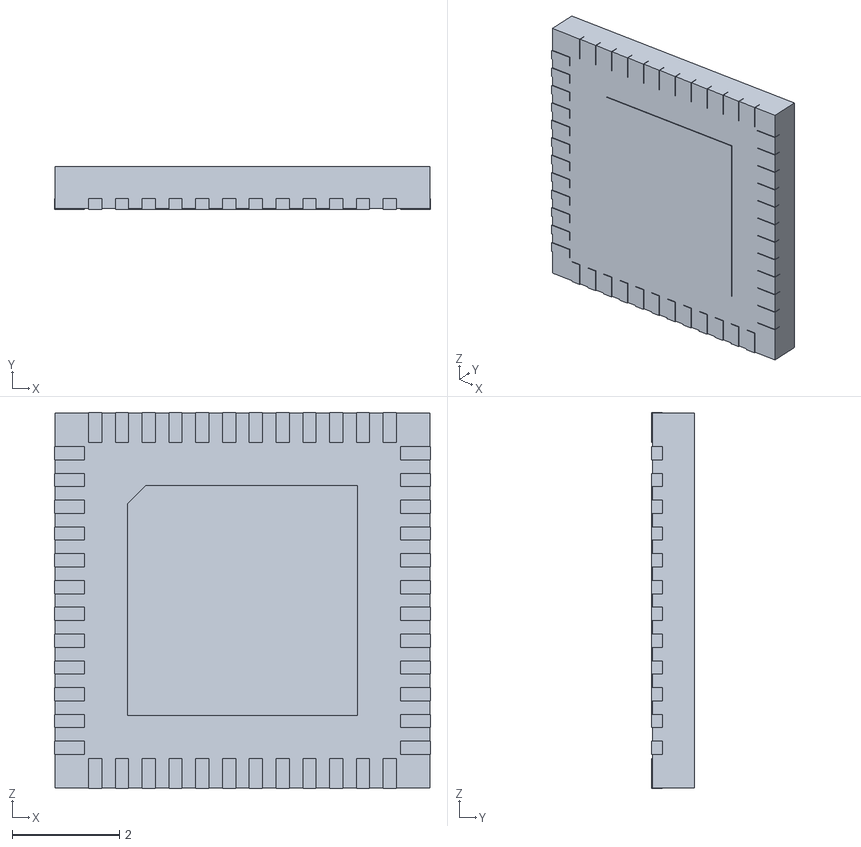
[picture p61: CAD file, 2018-07-28]
3d/User Library-QFN48_7x7.stl
7.02 x 0.8 x 7.02
