cGooding66/cLib/3d/23AR10KLFTR.step

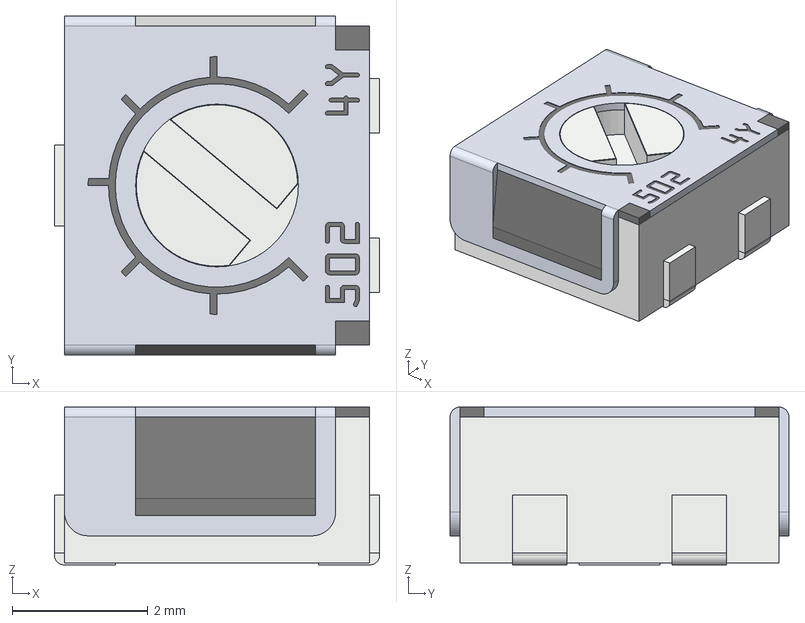
[picture p62: CAD file, 2018-07-28]
3d/23AR10KLFTR.step
4.80 x 5.00 x 2.33 mm
