cGooding66/cLib/3d/SOIC14.step

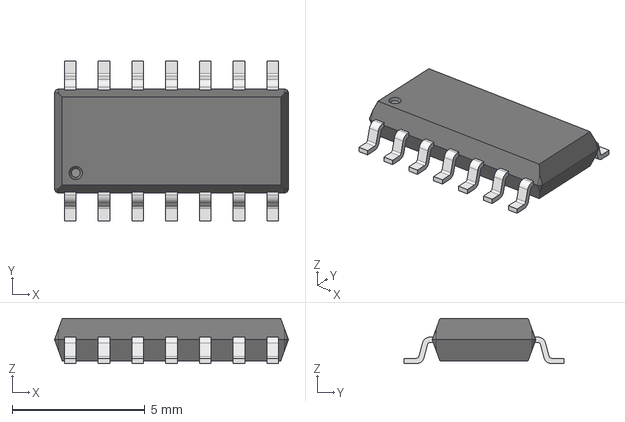
[picture p63: CAD file, 2018-07-28]
3d/SOIC14.step
8.80 x 6.00 x 1.70 mm
