cGooding66/cLib/3d/mstbva_2.5-7-g-5.08.step

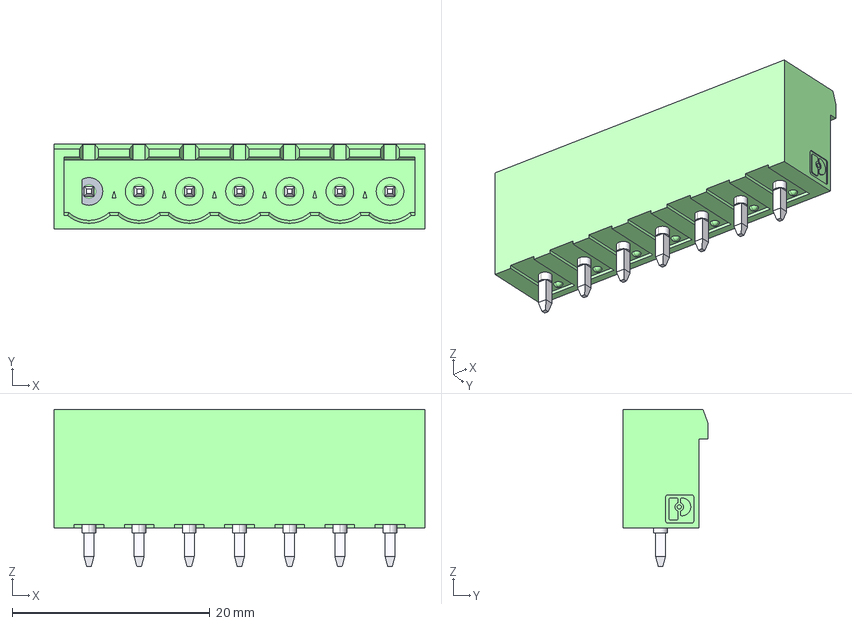
[picture p64: CAD file, 2018-07-28]
3d/mstbva_2.5-7-g-5.08.step
37.6 x 8.60 x 15.9 mm
