cGooding66/cLib/3d/Phoenix-2278364.step

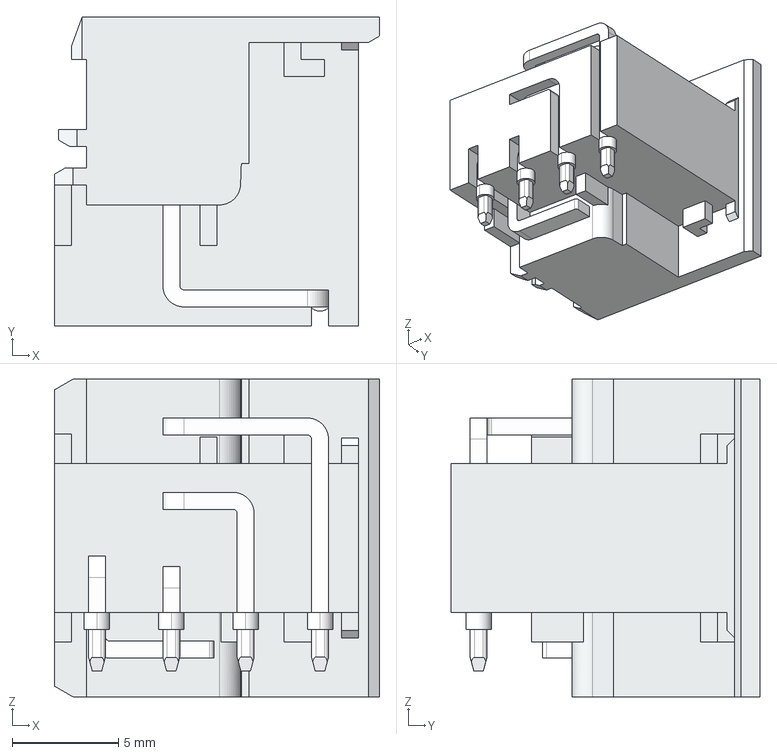
[picture p65: CAD file, 2018-07-28]
3d/Phoenix-2278364.step
15.3 x 14.6 x 15.0 mm
