cGooding66/cLib/3d/SSOP24.step

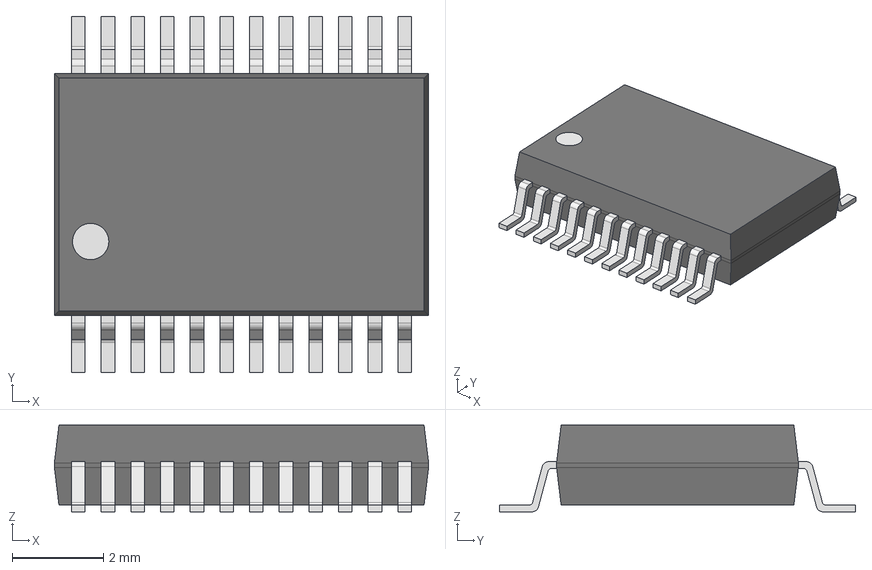
[picture p66: CAD file, 2018-07-28]
3d/SSOP24.step
8.20 x 7.80 x 1.90 mm
