cGooding66/cLib/3d/User Library-Common Mode Choke.stl

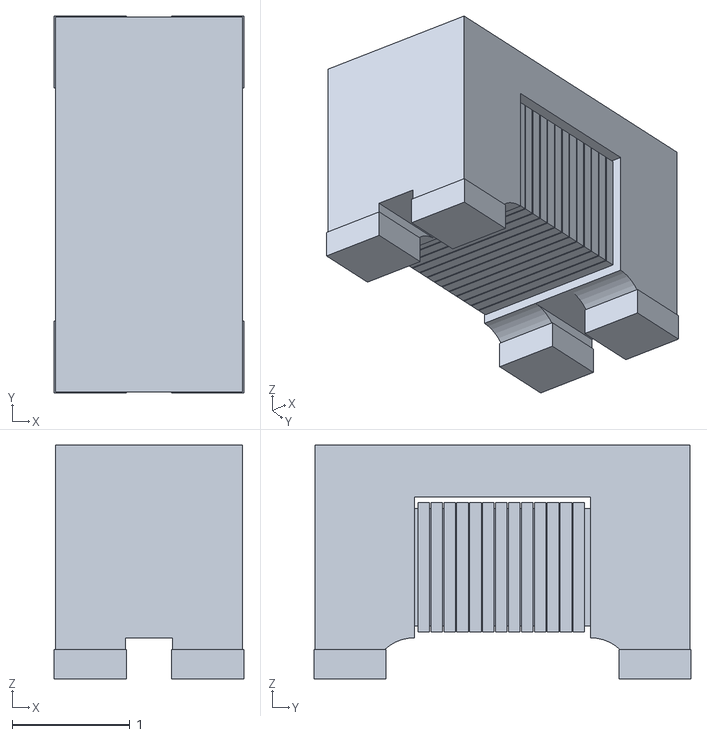
[picture p67: CAD file, 2018-07-28]
3d/User Library-Common Mode Choke.stl
1.61 x 3.21 x 1.99
