cGooding66/cLib/3d/DFN-8.step

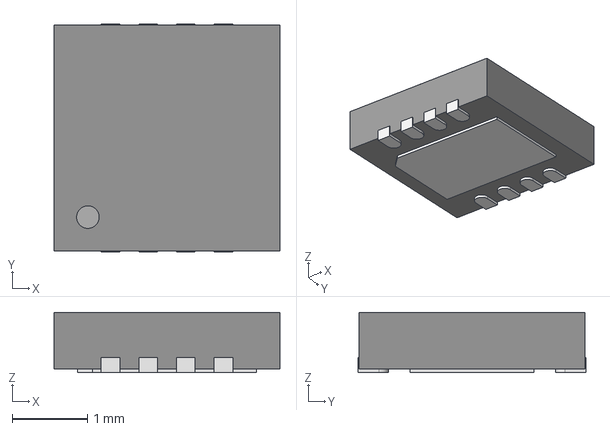
[picture p68: CAD file, 2018-07-28]
3d/DFN-8.step
3.00 x 3.02 x 0.8 mm
