cGooding66/cLib/3d/R_0603.step

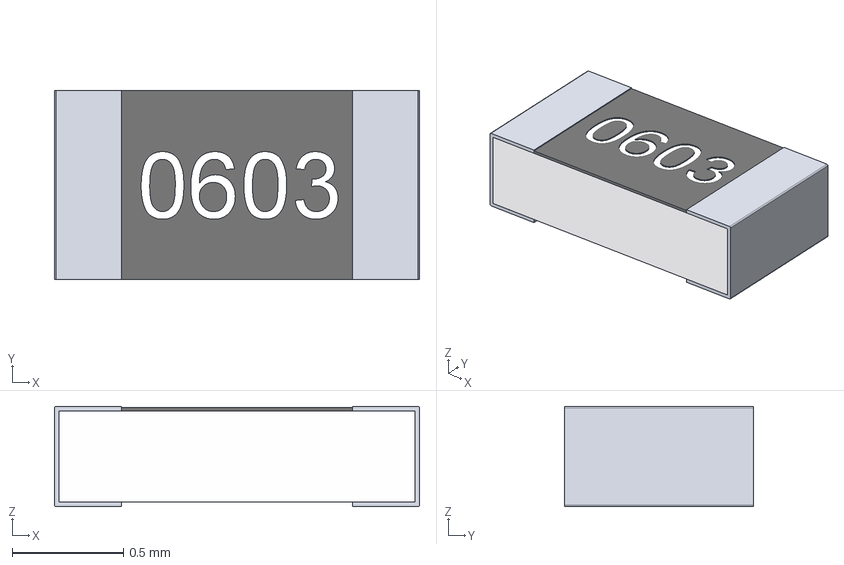
[picture p69: CAD file, 2018-07-28]
3d/R_0603.step
1.64 x 0.85 x 0.45 mm
