cGooding66/cLib/3d/23B_SW0001.step

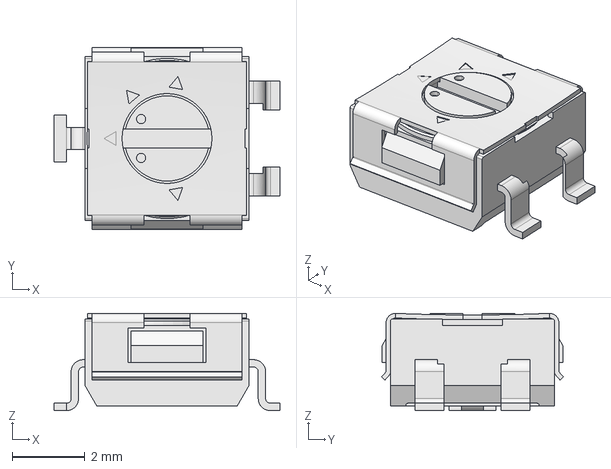
[picture p70: CAD file, 2018-07-28]
3d/23B_SW0001.step
6.20 x 4.99 x 2.67 mm
