cGooding66/cLib/3d/EEEFT1H220AR_CASE_C.step

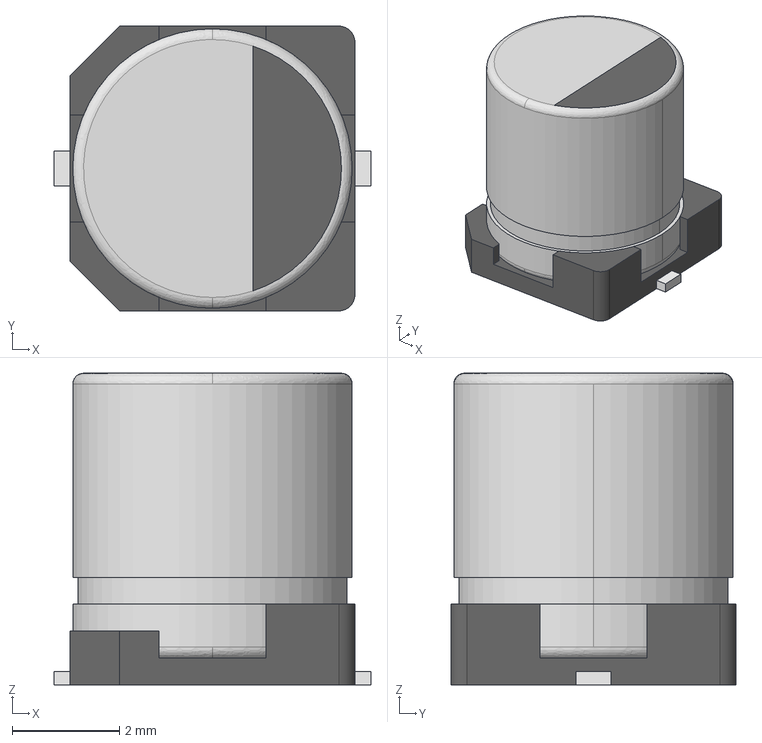
[picture p71: CAD file, 2018-07-28]
3d/EEEFT1H220AR_CASE_C.step
5.90 x 5.30 x 5.80 mm
