cGooding66/cLib/3d/BGA-7x7.step

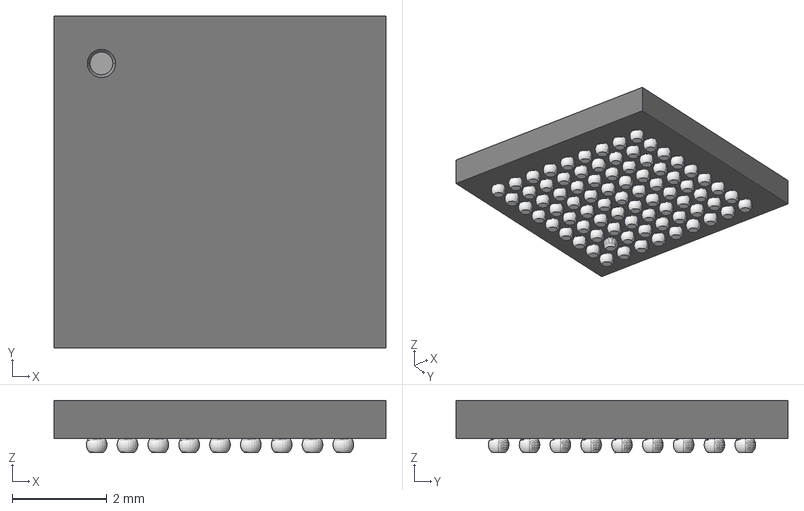
[picture p72: CAD file, 2018-07-28]
3d/BGA-7x7.step
7.00 x 7.00 x 1.10 mm
