cGooding66/cLib/3d/PX0412_04S.stp

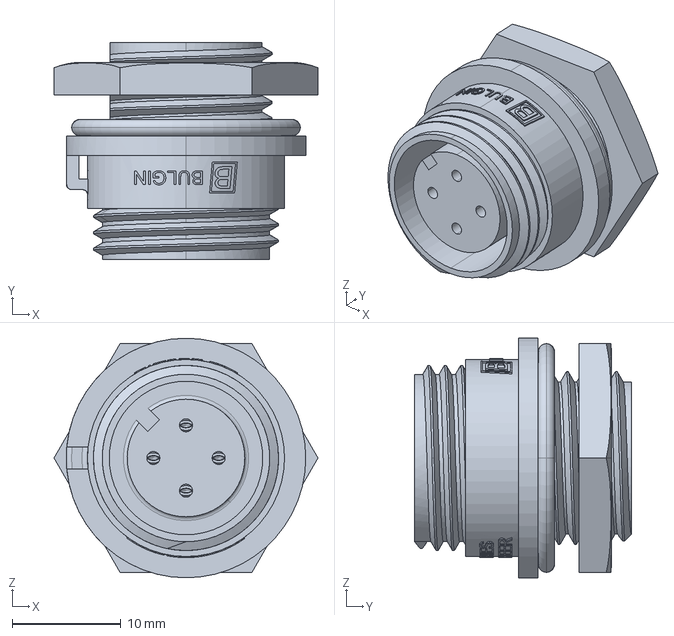
[picture p73: CAD file, 2018-07-28]
3d/PX0412_04S.stp
24.2 x 19.9 x 22.0 mm
