cGooding66/cLib/3d/ROE-0505S.step

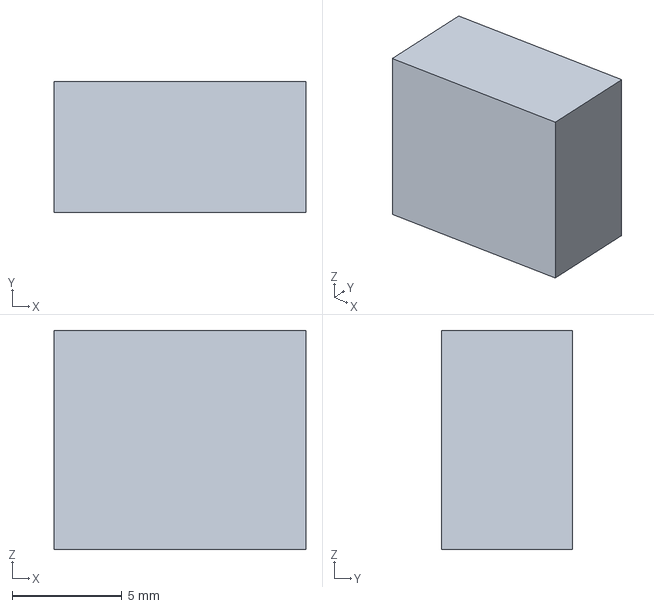
[picture p74: CAD file, 2018-07-28]
3d/ROE-0505S.step
11.5 x 6.00 x 10.0 mm
