cGooding66/cLib/3d/DIP8-GULLWING.step

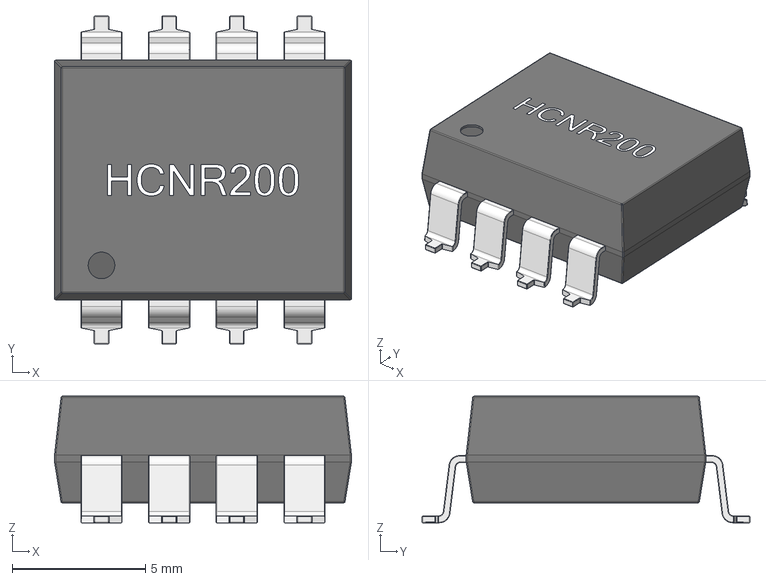
[picture p75: CAD file, 2018-07-28]
3d/DIP8-GULLWING.step
11.1 x 12.3 x 4.75 mm
