cGooding66/cLib/3d/3mmRED_LED.step

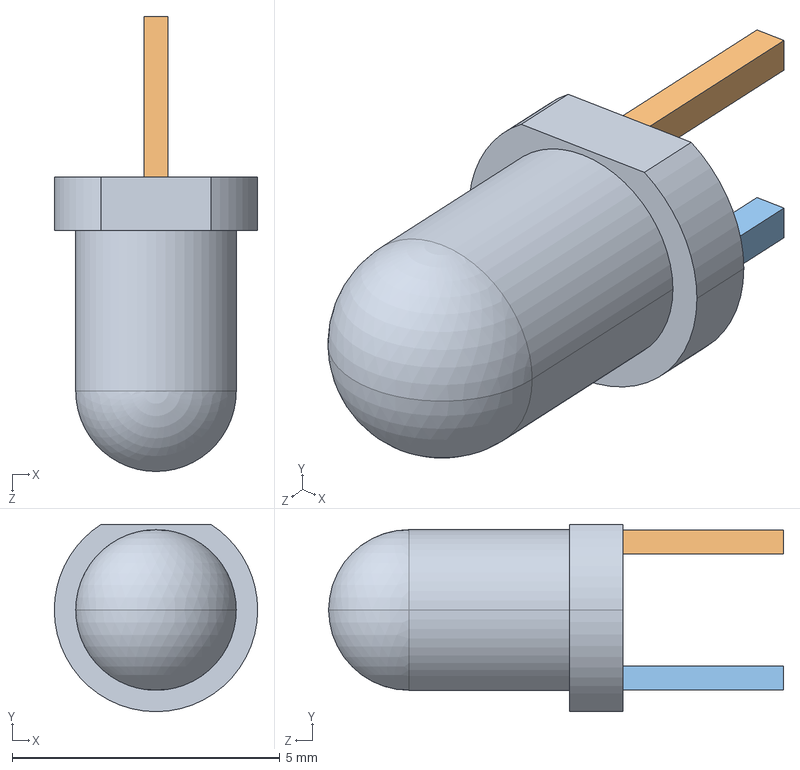
[picture p76: CAD file, 2018-07-28]
3d/3mmRED_LED.step
3.80 x 3.50 x 8.50 mm
