cGooding66/cLib/3d/SDR1105.step

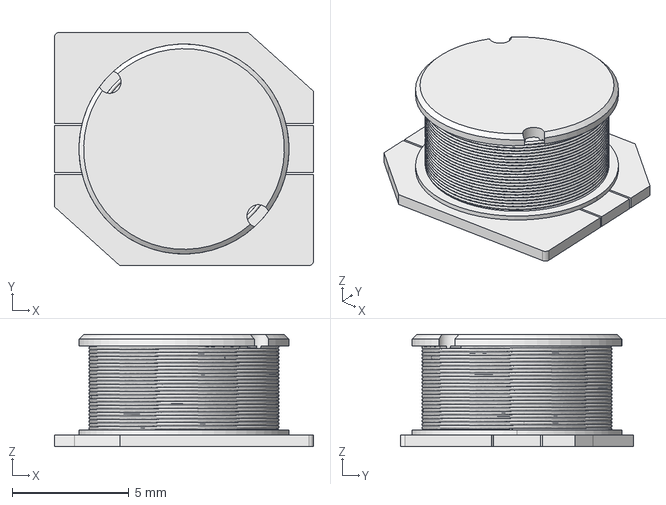
[picture p77: CAD file, 2018-07-28]
3d/SDR1105.step
11.1 x 10.0 x 4.80 mm
