cGooding66/cLib/3d/SO24-WIDE.step

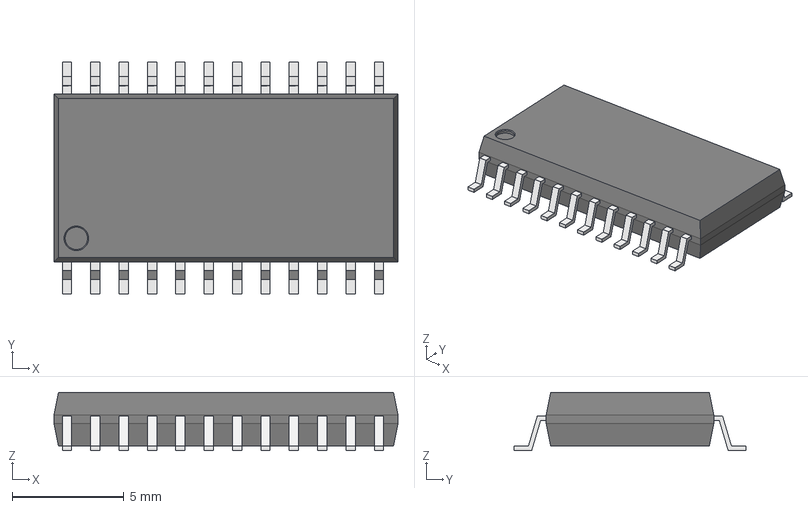
[picture p78: CAD file, 2018-07-28]
3d/SO24-WIDE.step
15.4 x 10.4 x 2.60 mm
