cGooding66/cLib/3d/M12A_05PMMP_SF8001_SW0001_cp.step

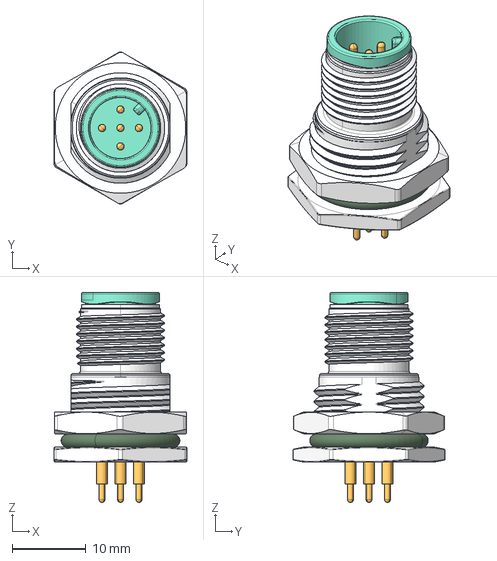
[picture p79: CAD file, 2018-07-28]
3d/M12A_05PMMP_SF8001_SW0001_cp.step
18.0 x 20.6 x 28.5 mm
