cGooding66/cLib/3d/User Library-SSOP 24 PIN_.stl

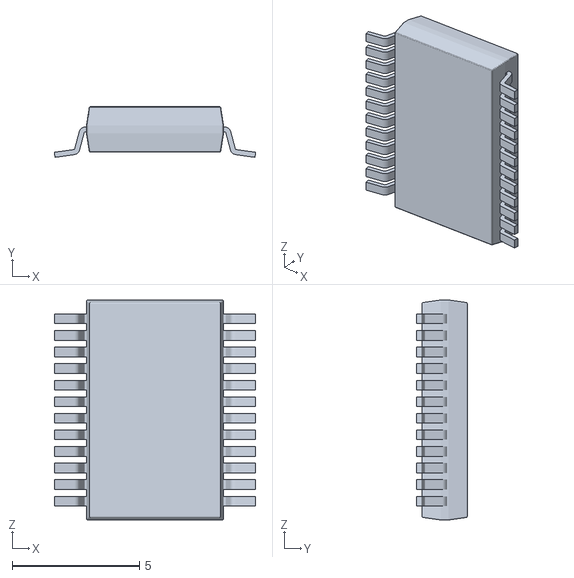
[picture p80: CAD file, 2018-07-28]
3d/User Library-SSOP 24 PIN_.stl
7.90 x 1.99 x 8.63
