cGooding66/cLib/3d/HCNR201.step

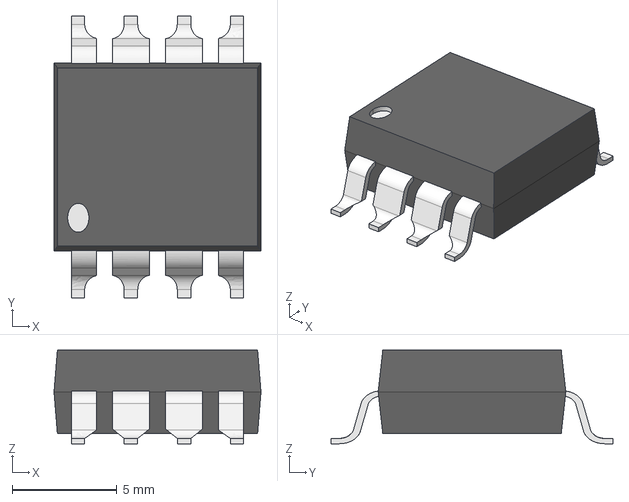
[picture p81: CAD file, 2018-07-28]
3d/HCNR201.step
9.90 x 13.5 x 4.47 mm
