cGooding66/cLib/3d/R_0805.step

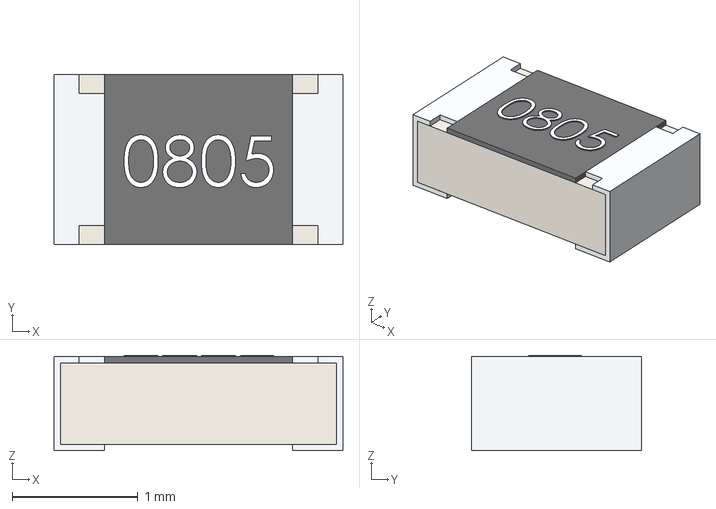
[picture p82: CAD file, 2018-07-28]
3d/R_0805.step
2.30 x 1.35 x 0.76 mm
