cGooding66/cLib/3d/User Library-so8-3.stl

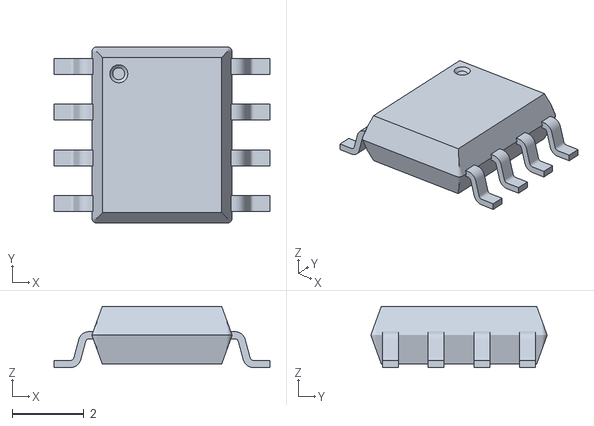
[picture p83: CAD file, 2018-07-28]
3d/User Library-so8-3.stl
6.00 x 4.90 x 1.70
