cGooding66/cLib/3d/C_0603.step

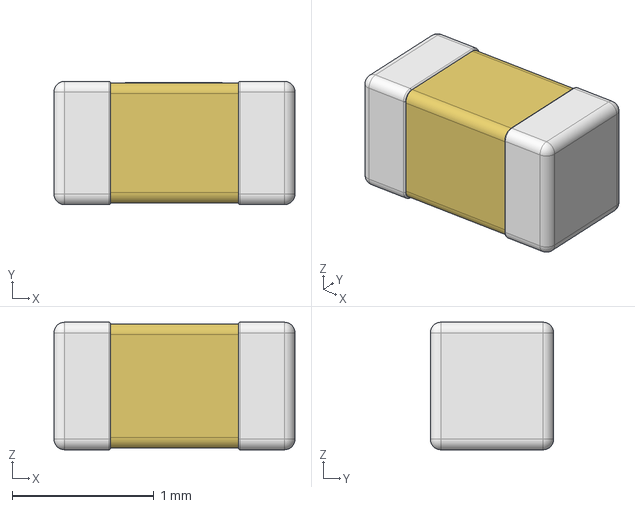
[picture p84: CAD file, 2018-07-28]
3d/C_0603.step
1.70 x 0.87 x 0.9 mm
