cGooding66/cLib/3d/DO214AA.step

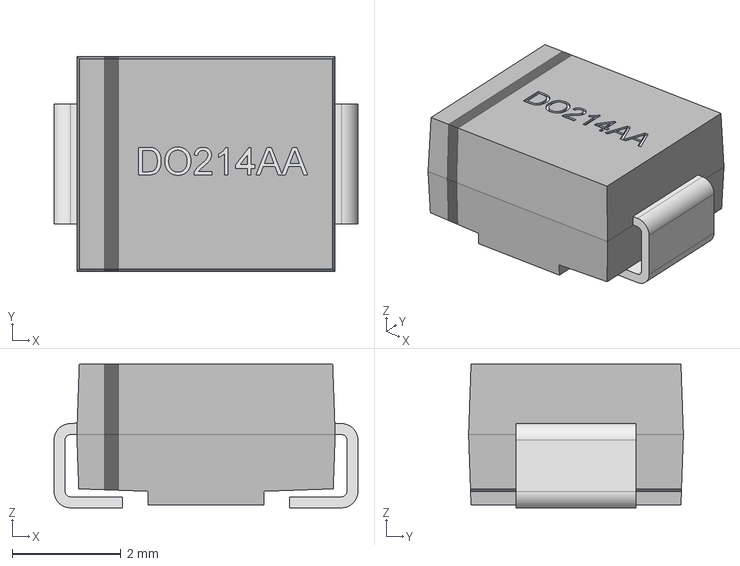
[picture p85: CAD file, 2018-07-28]
3d/DO214AA.step
5.59 x 3.95 x 2.64 mm
