cGooding66/cLib/3d/Molex-502584-0260.step

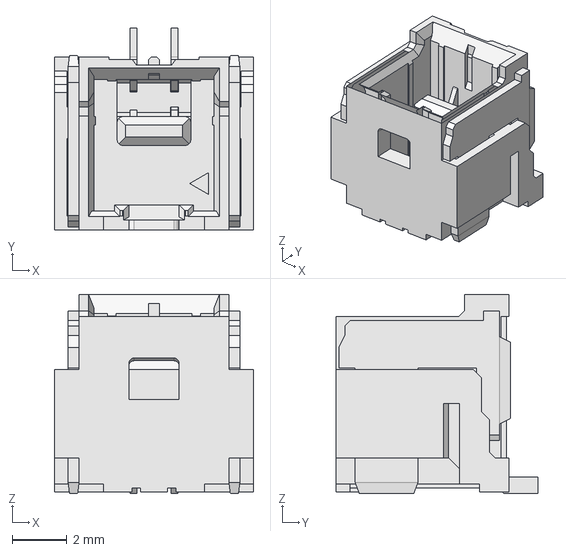
[picture p86: CAD file, 2018-07-28]
3d/Molex-502584-0260.step
7.30 x 7.40 x 7.30 mm
