cGooding66/cLib/3d/BM06B-SRSS.step

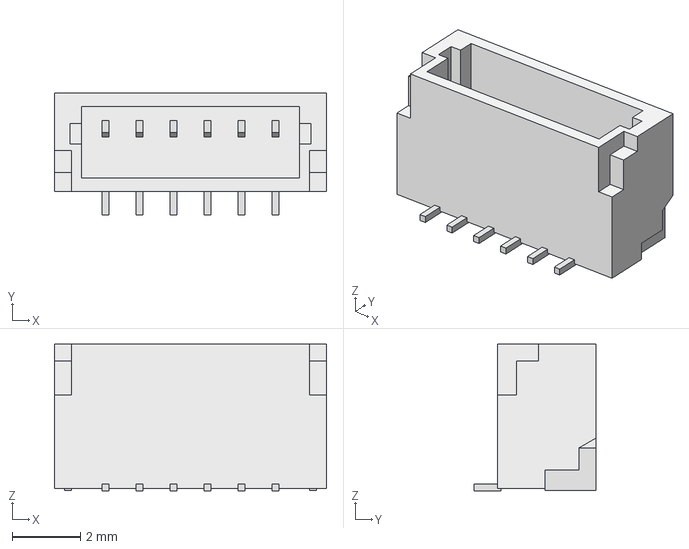
[picture p87: CAD file, 2018-07-28]
3d/BM06B-SRSS.step
8.00 x 3.60 x 4.32 mm
