cGooding66/cLib/3d/ABM8.step

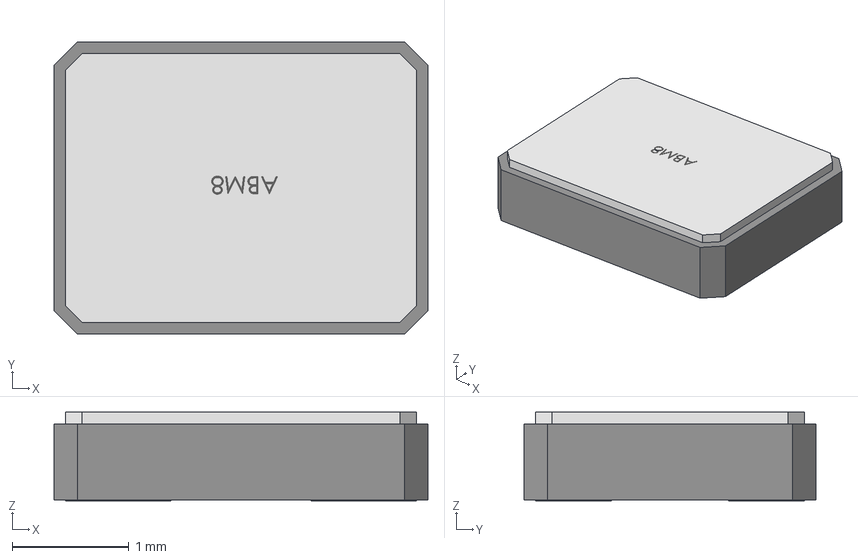
[picture p88: CAD file, 2018-07-28]
3d/ABM8.step
3.20 x 2.50 x 0.761 mm
