cGooding66/cLib/3d/UFL.step

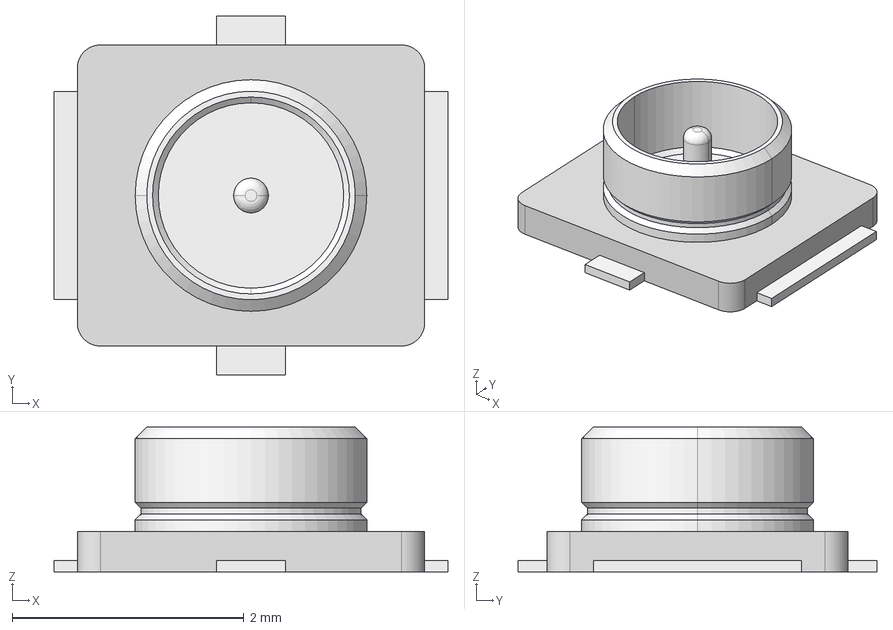
[picture p89: CAD file, 2018-07-28]
3d/UFL.step
3.40 x 3.10 x 1.25 mm
