cGooding66/cLib/3d/User Library-res2512.STEP

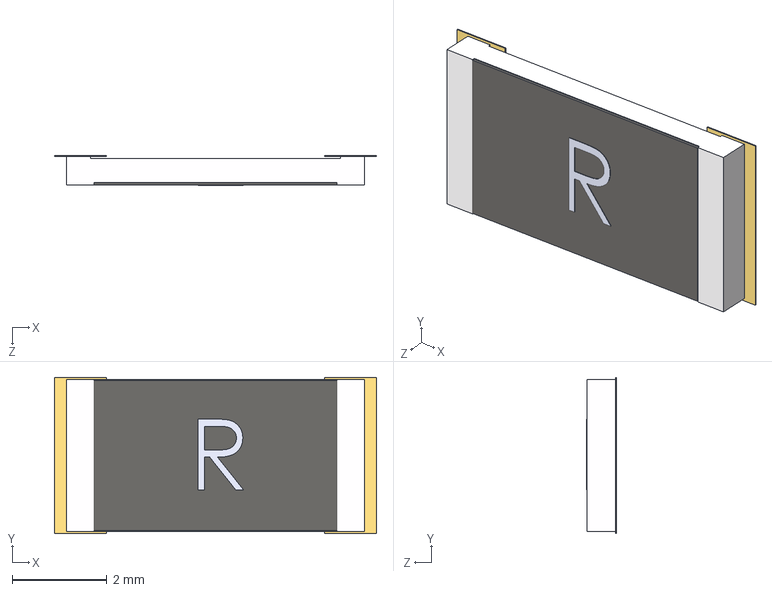
[picture p90: CAD file, 2018-07-28]
3d/User Library-res2512.STEP
6.80 x 3.30 x 0.641 mm
User Library-res2512_pad_2512___
User Library-res2512_res2512_body___
