cGooding66/cLib/3d/R_2010.step

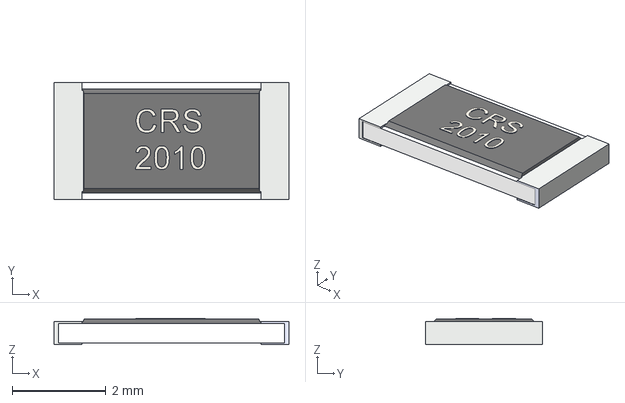
[picture p91: CAD file, 2018-07-28]
3d/R_2010.step
5.00 x 2.50 x 0.56 mm
