cGooding66/cLib/3d/User Library-PowerPAK SO-8 (S).step

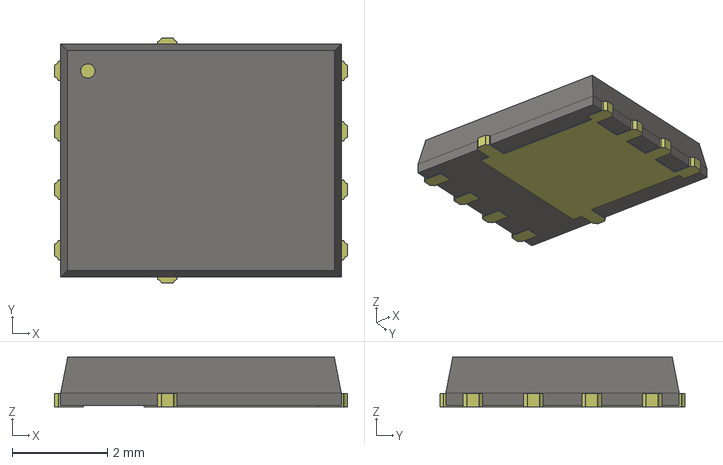
[picture p92: CAD file, 2018-07-28]
3d/User Library-PowerPAK SO-8 (S).step
6.15 x 5.15 x 1.04 mm
