cGooding66/cLib/3d/SOD323.step

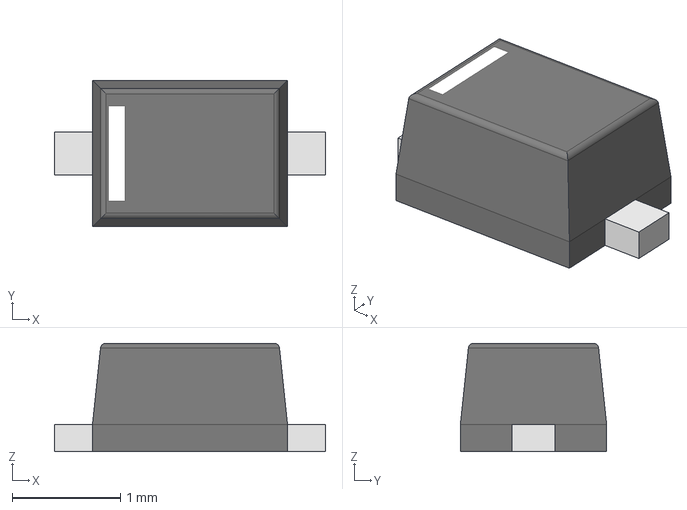
[picture p93: CAD file, 2018-07-28]
3d/SOD323.step
2.50 x 1.35 x 1.00 mm
