cGooding66/cLib/3d/User Library-DIOM5539X24.step

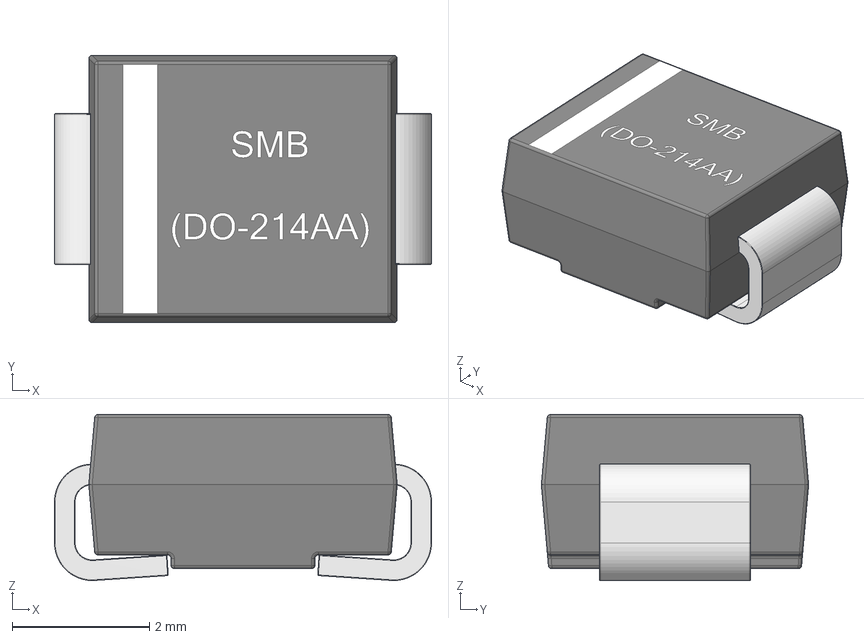
[picture p94: CAD file, 2018-07-28]
3d/User Library-DIOM5539X24.step
5.50 x 3.90 x 2.42 mm
