cGooding66/cLib/3d/EEEFT1H331AP.step

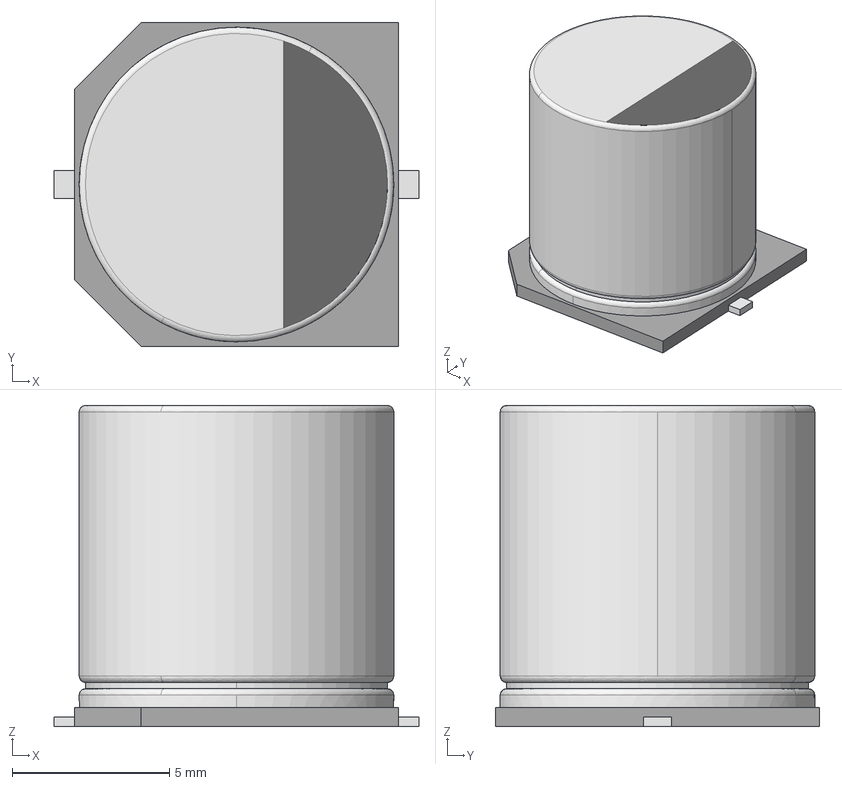
[picture p95: CAD file, 2018-07-28]
3d/EEEFT1H331AP.step
11.6 x 10.3 x 10.2 mm
