cGooding66/cLib/3d/TFM_105_02_L_DH_cp.step

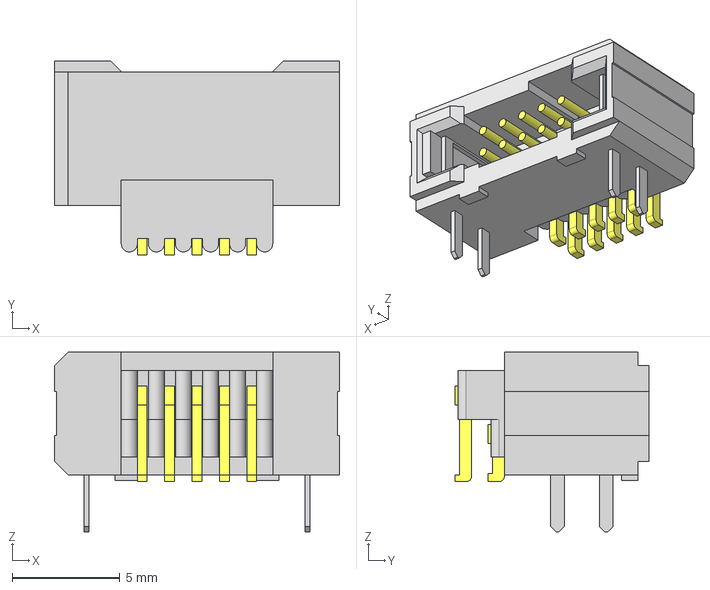
[picture p96: CAD file, 2018-07-28]
3d/TFM_105_02_L_DH_cp.step
13.2 x 8.99 x 8.36 mm
