cGooding66/cLib/3d/sot23.step

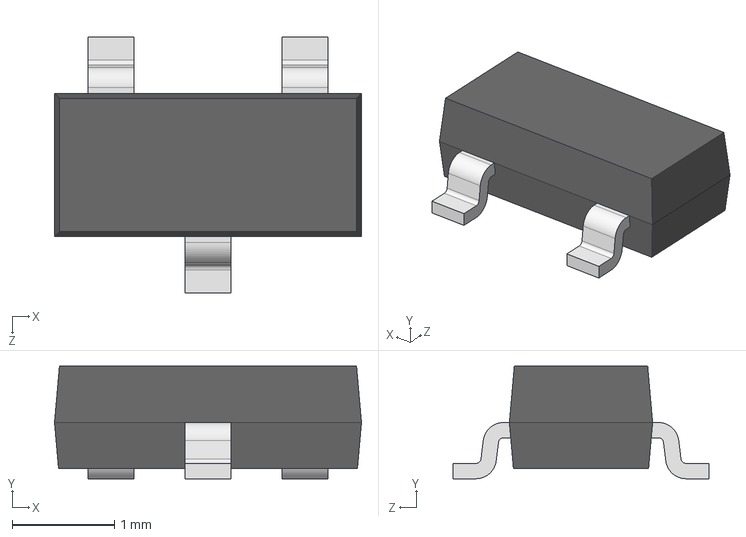
[picture p97: CAD file, 2018-07-28]
3d/sot23.step
3.00 x 1.10 x 2.50 mm
