cGooding66/cLib/3d/DIOM8261X24.step

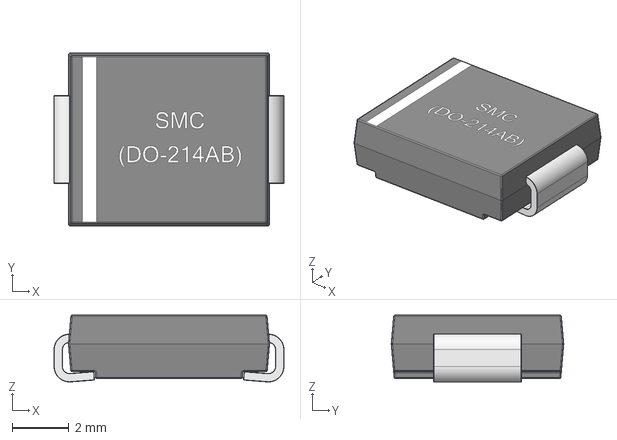
[picture p98: CAD file, 2018-07-28]
3d/DIOM8261X24.step
8.13 x 6.10 x 2.37 mm
