cGooding66/cLib/3d/User Library-SOD323F-1.stl

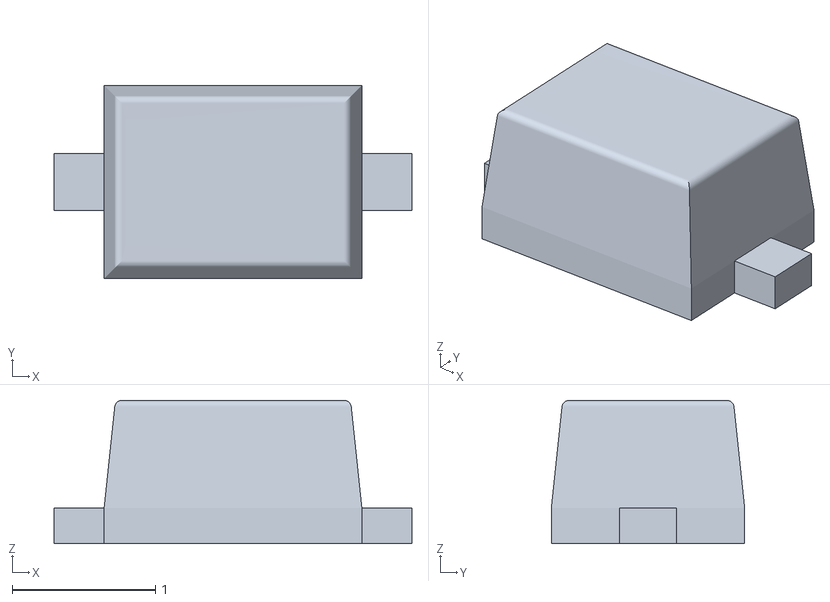
[picture p99: CAD file, 2018-07-28]
3d/User Library-SOD323F-1.stl
2.50 x 1.35 x 1
