cGooding66/cLib/3d/SOT363.step

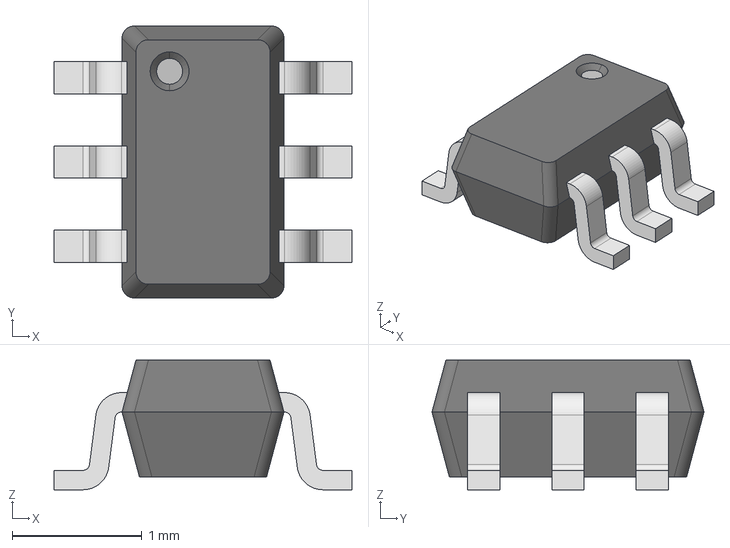
[picture p100: CAD file, 2018-07-28]
3d/SOT363.step
2.30 x 2.10 x 1.00 mm
