cGooding66/cLib/3d/Resistor-THT-0.6W.FCStd

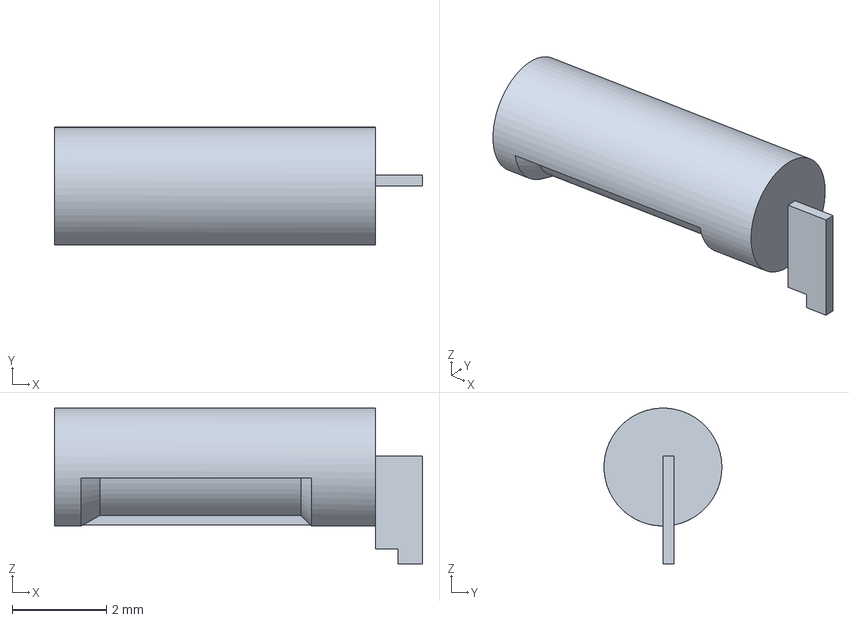
[picture p101: CAD file, 2018-07-28]
3d/Resistor-THT-0.6W.FCStd
7.80 x 2.50 x 3.30 mm
