cGooding66/cLib/3d/3557.step

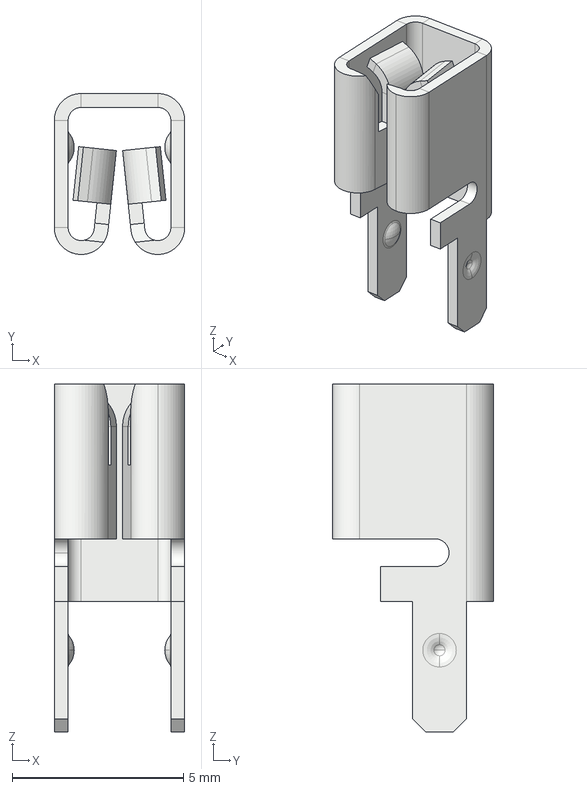
[picture p102: CAD file, 2018-07-28]
3d/3557.step
3.81 x 4.70 x 10.2 mm
