cGooding66/cLib/3d/TSSOP8-4.4mm.step

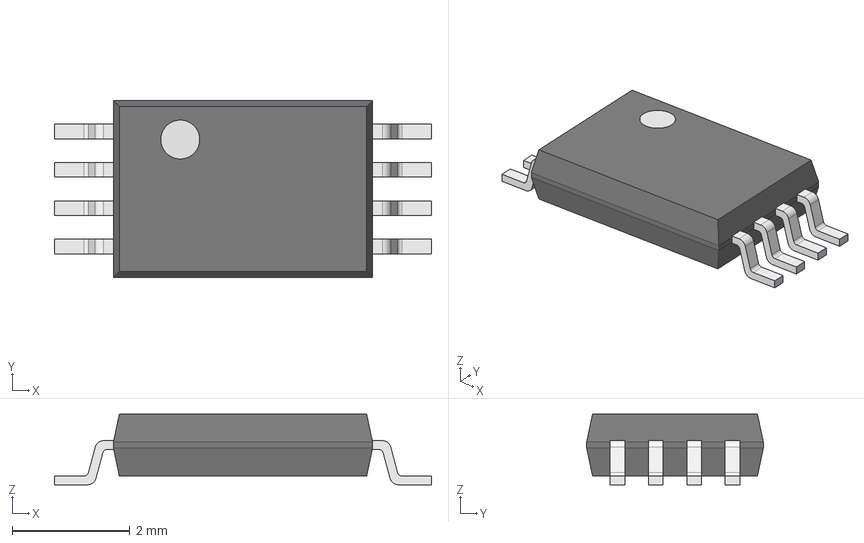
[picture p103: CAD file, 2018-07-28]
3d/TSSOP8-4.4mm.step
6.40 x 3.00 x 1.20 mm
