cGooding66/cLib/3d/SOD128.step

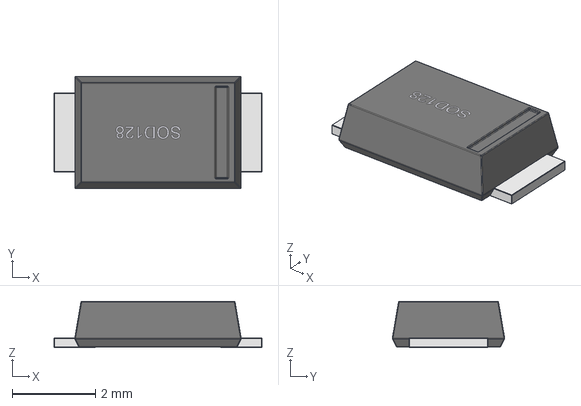
[picture p104: CAD file, 2018-07-28]
3d/SOD128.step
5.00 x 2.70 x 1.11 mm
