cGooding66/cLib/3d/0966_Dsub-S_low_profile_male_angled_25-pins_board_lock.step

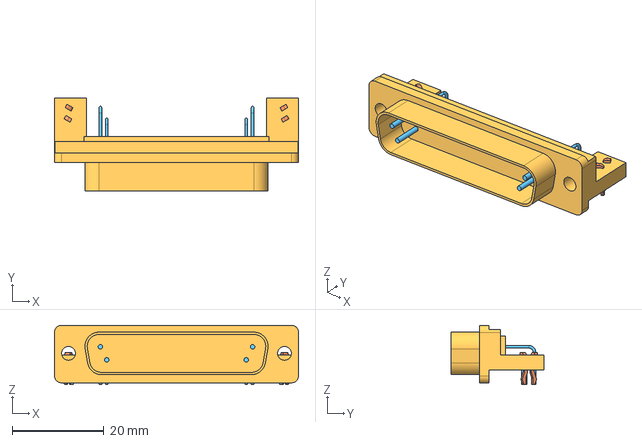
[picture p105: CAD file, 2018-07-28]
3d/0966_Dsub-S_low_profile_male_angled_25-pins_board_lock.step
53.1 x 20.2 x 12.9 mm
