cGooding66/cLib/3d/M2.5x6.stp

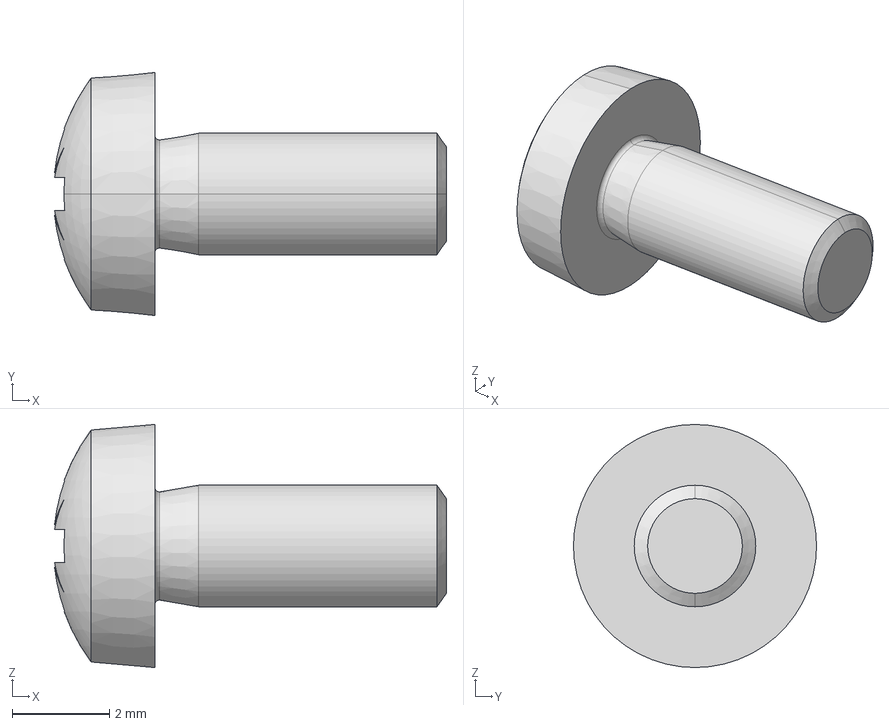
[picture p106: CAD file, 2018-07-28]
3d/M2.5x6.stp
8.06 x 5.00 x 5.00 mm
