cGooding66/cLib/3d/TMM-103-01-G-S-SM.step

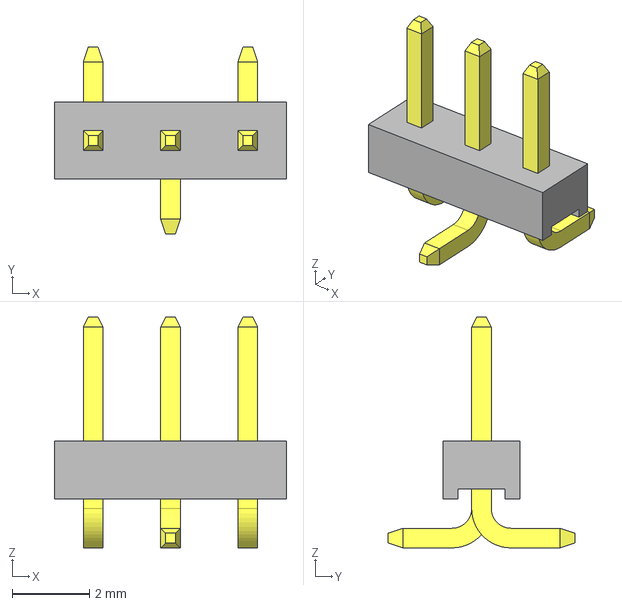
[picture p107: CAD file, 2018-07-28]
3d/TMM-103-01-G-S-SM.step
6.00 x 4.83 x 5.97 mm
