cGooding66/cLib/3d/SRF2012.step

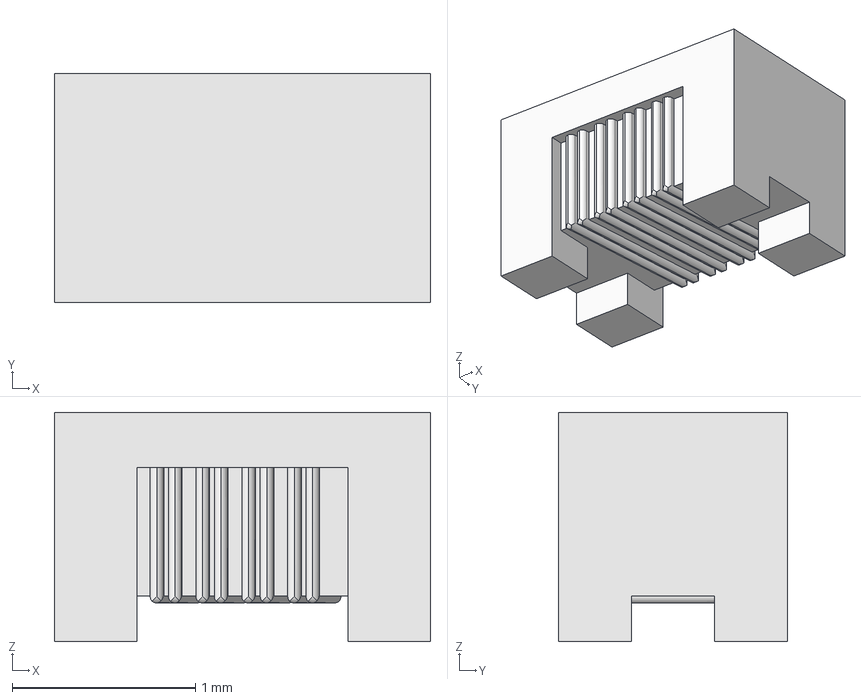
[picture p108: CAD file, 2018-07-28]
3d/SRF2012.step
2.05 x 1.25 x 1.25 mm
