cGooding66/cLib/3d/TSSOP-8_3.1x3.1.step

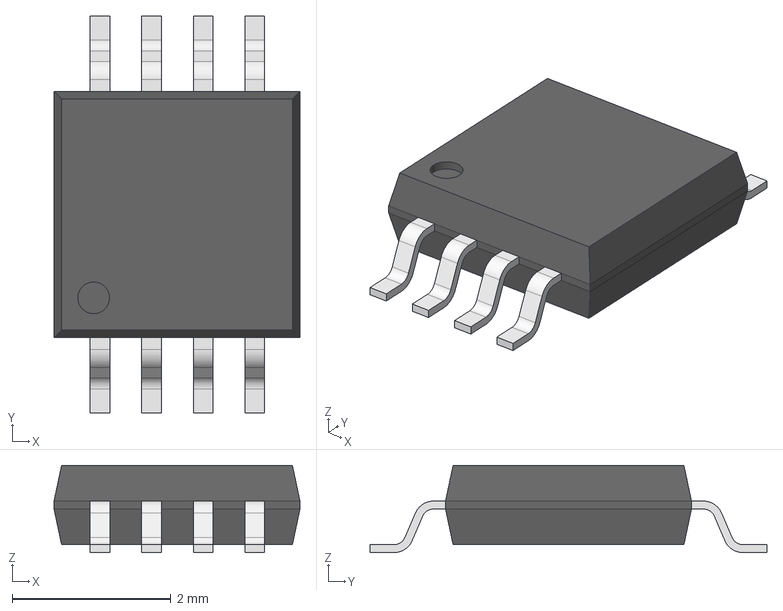
[picture p109: CAD file, 2018-07-28]
3d/TSSOP-8_3.1x3.1.step
3.10 x 5.00 x 1.10 mm
