cGooding66/cLib/3d/Inductor_1812.step

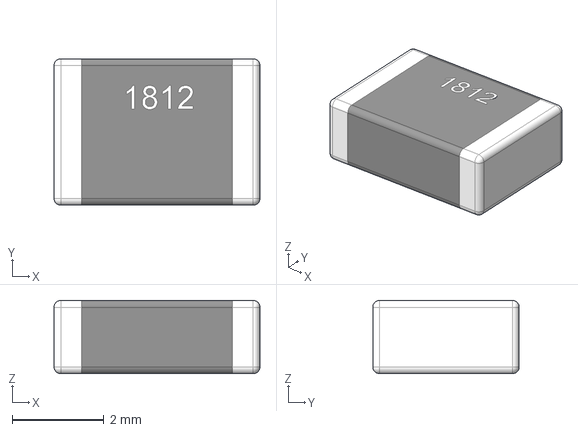
[picture p110: CAD file, 2018-07-28]
3d/Inductor_1812.step
4.50 x 3.20 x 1.60 mm
