cGooding66/cLib/3d/B8B-PH-K-S.step

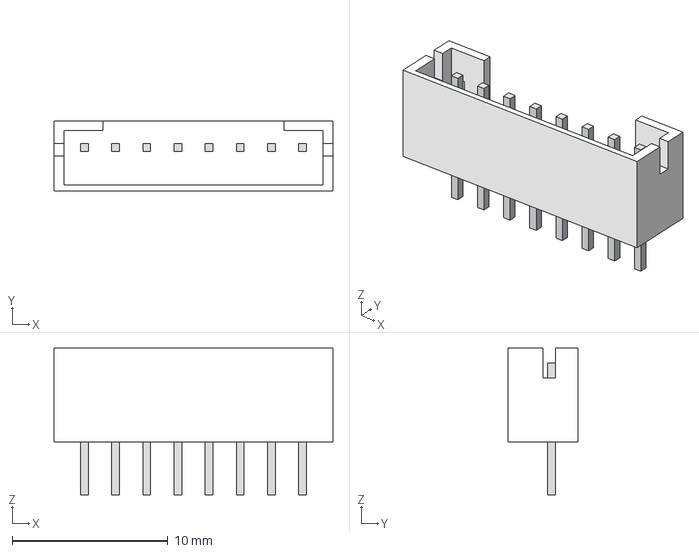
[picture p111: CAD file, 2018-07-28]
3d/B8B-PH-K-S.step
17.9 x 4.50 x 9.40 mm
