cGooding66/cLib/3d/SDR1307.step

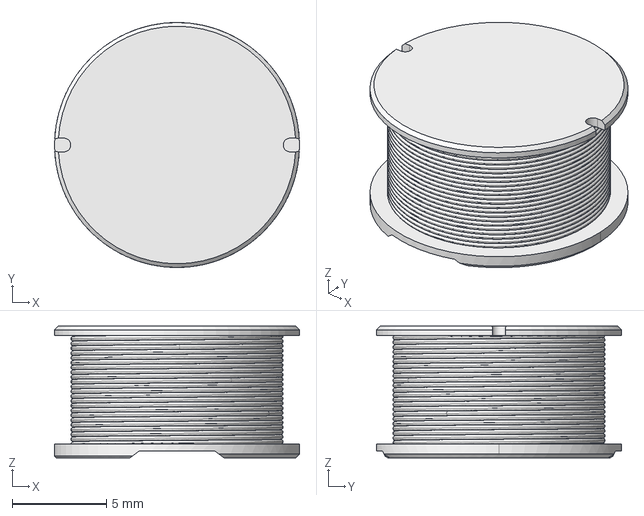
[picture p112: CAD file, 2018-07-28]
3d/SDR1307.step
13.0 x 13.0 x 7.00 mm
