cGooding66/cLib/3d/TANT_CASE-C.wrl.step

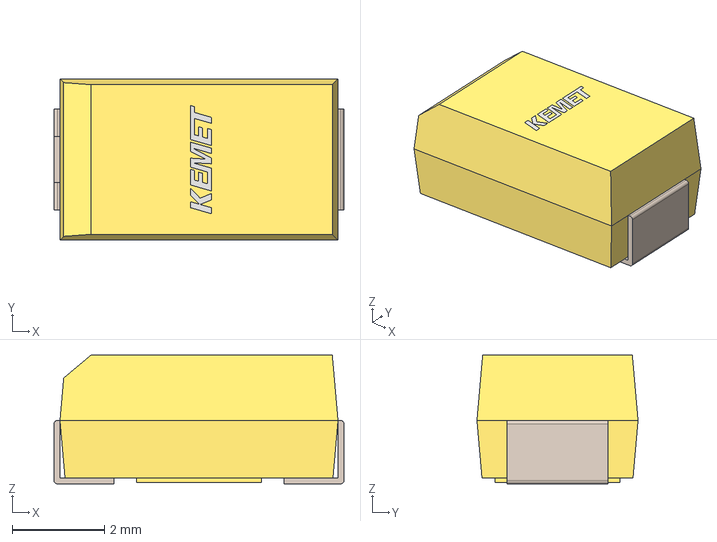
[picture p113: CAD file, 2018-07-28]
3d/TANT_CASE-C.wrl.step
6.30 x 3.50 x 2.80 mm
