cGooding66/cLib/3d/R_1206.step

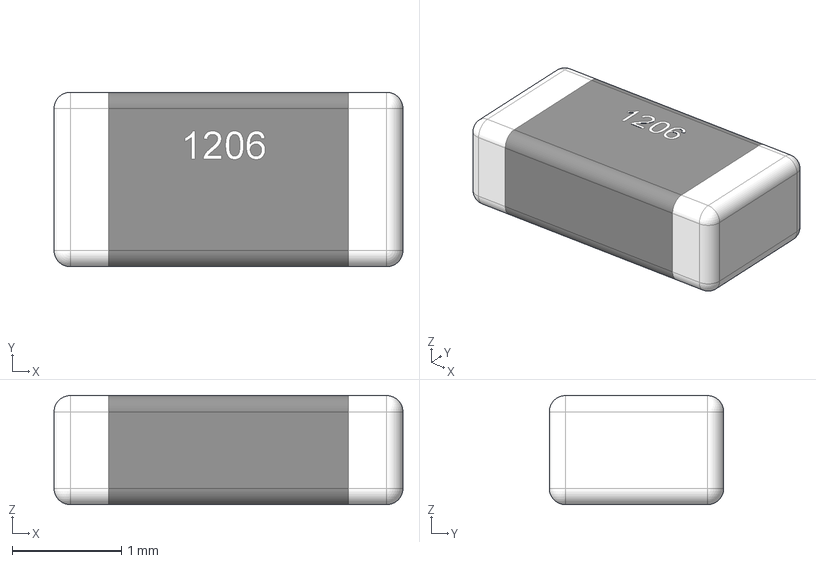
[picture p114: CAD file, 2018-07-28]
3d/R_1206.step
3.20 x 1.60 x 1.00 mm
