cGooding66/cLib/3d/SON-8(3x2).step

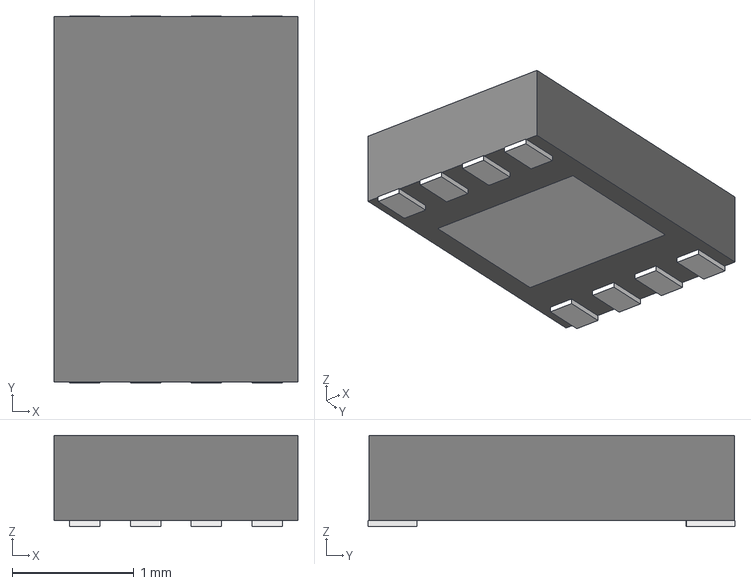
[picture p115: CAD file, 2018-07-28]
3d/SON-8(3x2).step
2.00 x 3.01 x 0.75 mm
