cGooding66/cLib/3d/neo.FCStd

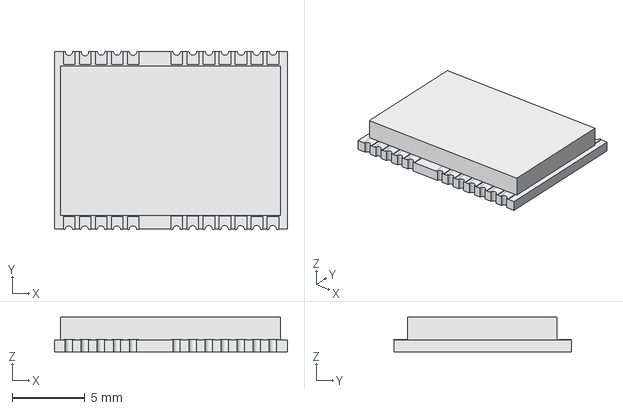
[picture p116: CAD file, 2018-07-28]
3d/neo.FCStd
16.0 x 12.2 x 2.40 mm
