cGooding66/cLib/3d/R_2512.step

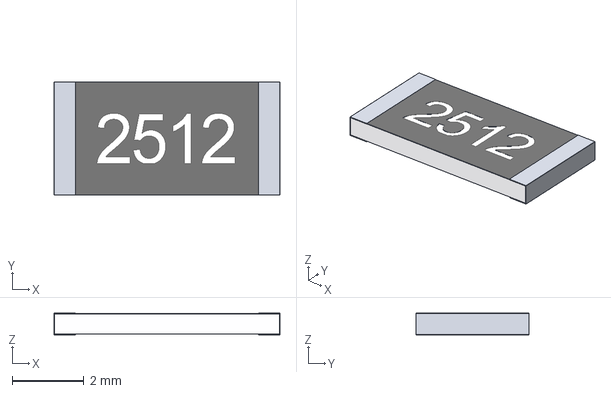
[picture p117: CAD file, 2018-07-28]
3d/R_2512.step
6.30 x 3.15 x 0.6 mm
