cGooding66/cLib/3d/43F8B324-C2A5-4E0C-A51D-10CBD7900D86.step

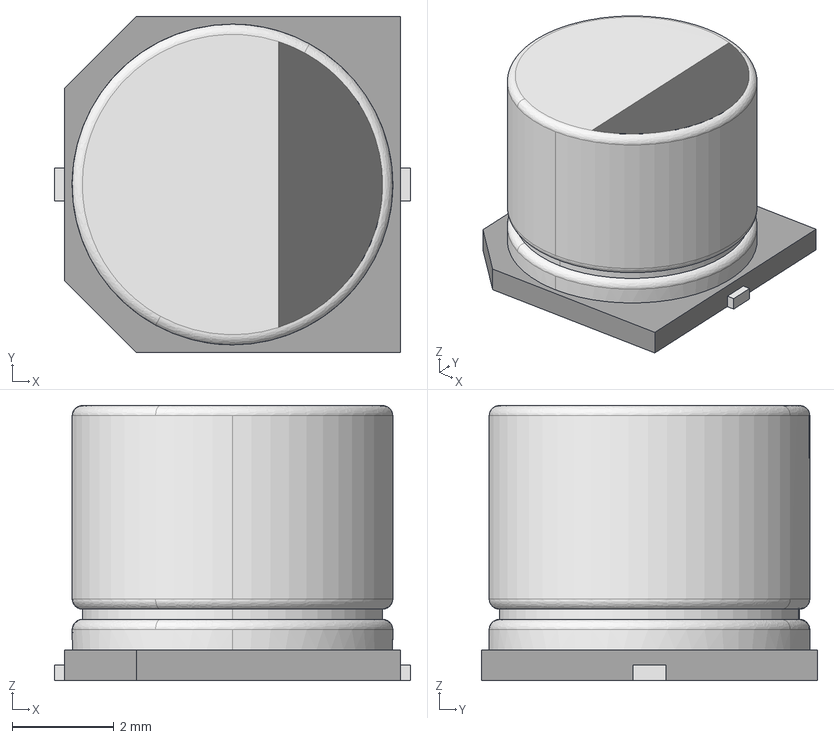
[picture p118: CAD file, 2018-07-28]
3d/43F8B324-C2A5-4E0C-A51D-10CBD7900D86.step
7.00 x 6.60 x 5.41 mm
