cGooding66/cLib/3d/ESK106M050AC3AA.step

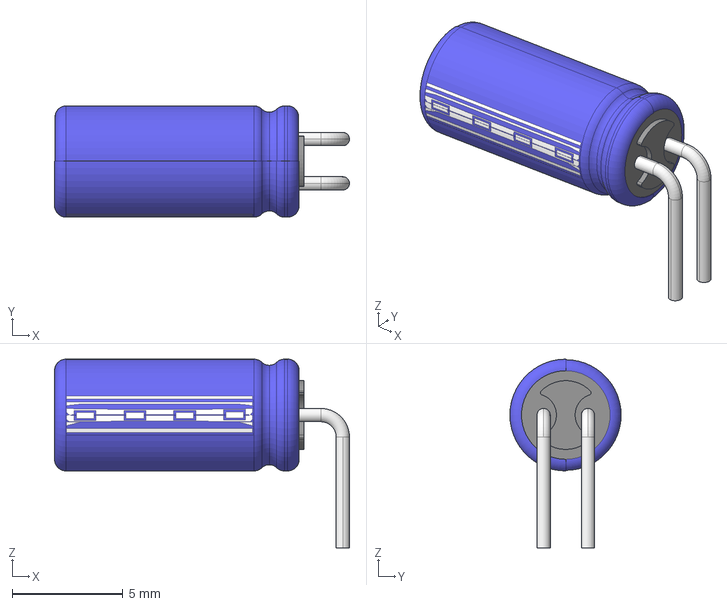
[picture p119: CAD file, 2018-07-28]
3d/ESK106M050AC3AA.step
13.3 x 5.03 x 8.53 mm
