cGooding66/cLib/3d/DFN12(3x3).step

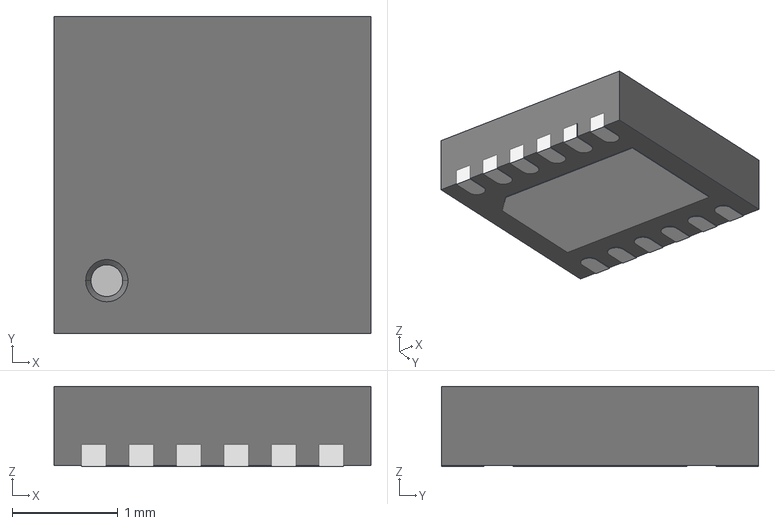
[picture p120: CAD file, 2018-07-28]
3d/DFN12(3x3).step
3.00 x 3.00 x 0.76 mm
