cGooding66/cLib/3d/B9B-PH-K-S.step

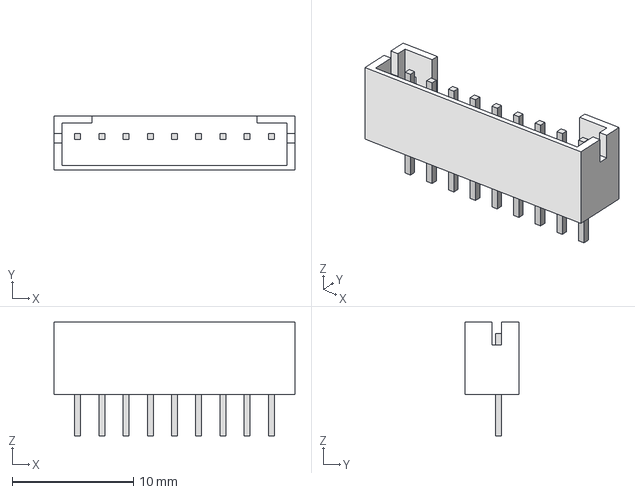
[picture p121: CAD file, 2018-07-28]
3d/B9B-PH-K-S.step
19.9 x 4.50 x 9.40 mm
