cGooding66/cLib/3d/EEEFTE221XAP.step

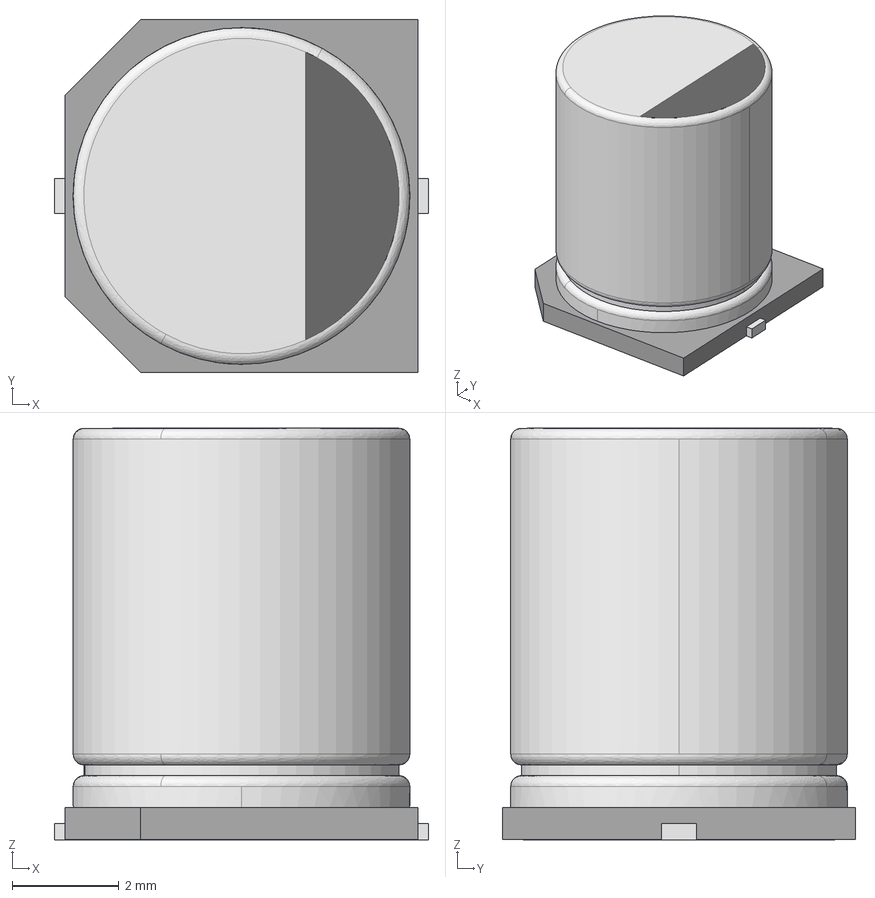
[picture p122: CAD file, 2018-07-28]
3d/EEEFTE221XAP.step
7.00 x 6.60 x 7.71 mm
