cGooding66/cLib/3d/SW3dPS-0805 SMD Capacitor.step

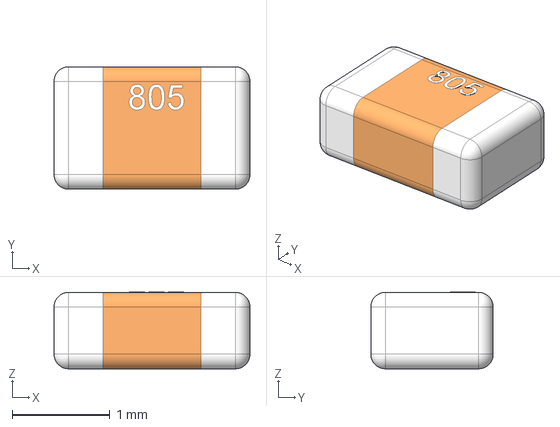
[picture p123: CAD file, 2018-07-28]
3d/SW3dPS-0805 SMD Capacitor.step
2.00 x 1.25 x 0.782 mm
