cGooding66/cLib/3d/1225.step

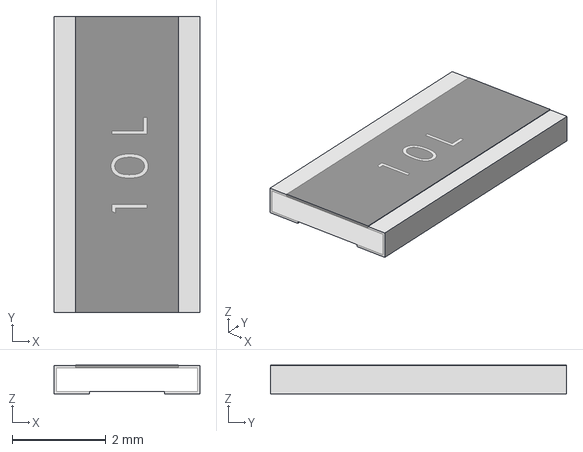
[picture p124: CAD file, 2018-07-28]
3d/1225.step
3.10 x 6.30 x 0.612 mm
