cGooding66/cLib/3d/SOD123.step

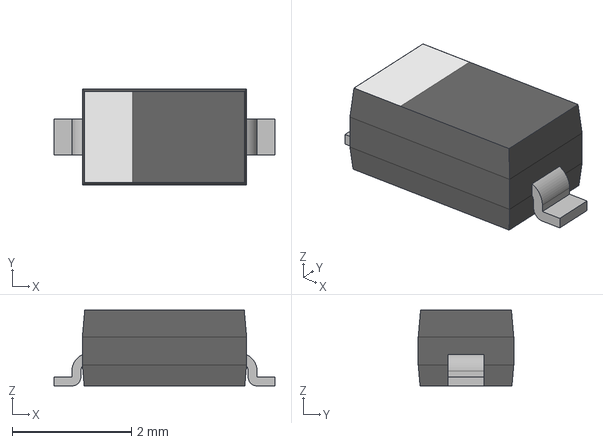
[picture p125: CAD file, 2018-07-28]
3d/SOD123.step
3.70 x 1.60 x 1.27 mm
