cGooding66/cLib/3d/WSON0.65.step

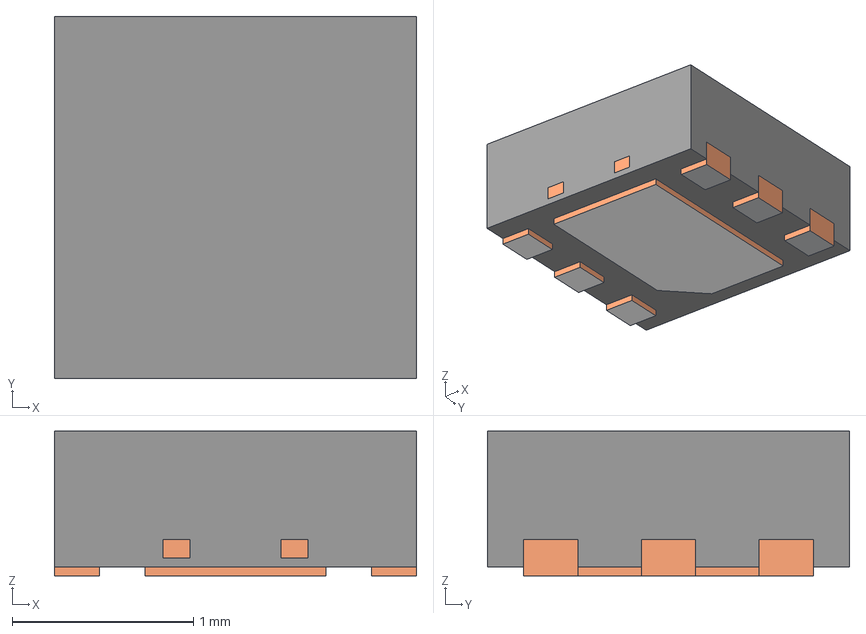
[picture p126: CAD file, 2018-07-28]
3d/WSON0.65.step
2.00 x 2.00 x 0.8 mm
