cGooding66/cLib/3d/LED-GREEN-0603.step

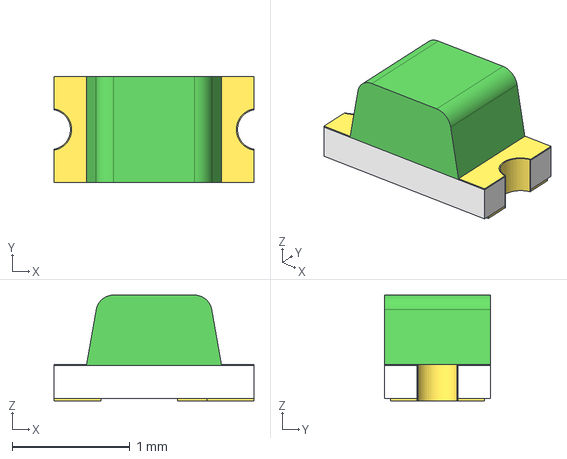
[picture p127: CAD file, 2018-07-28]
3d/LED-GREEN-0603.step
1.70 x 0.9 x 0.9 mm
