cGooding66/cLib/3d/5GSH93542.step

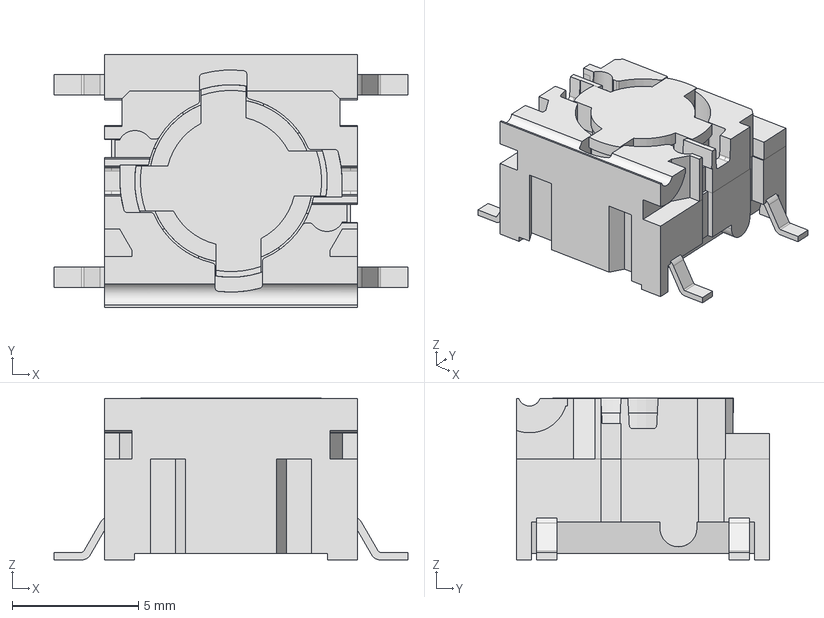
[picture p128: CAD file, 2018-07-28]
3d/5GSH93542.step
14.0 x 10.0 x 6.40 mm
