cGooding66/cLib/3d/2411_01_USB-VERTICAL-C.step

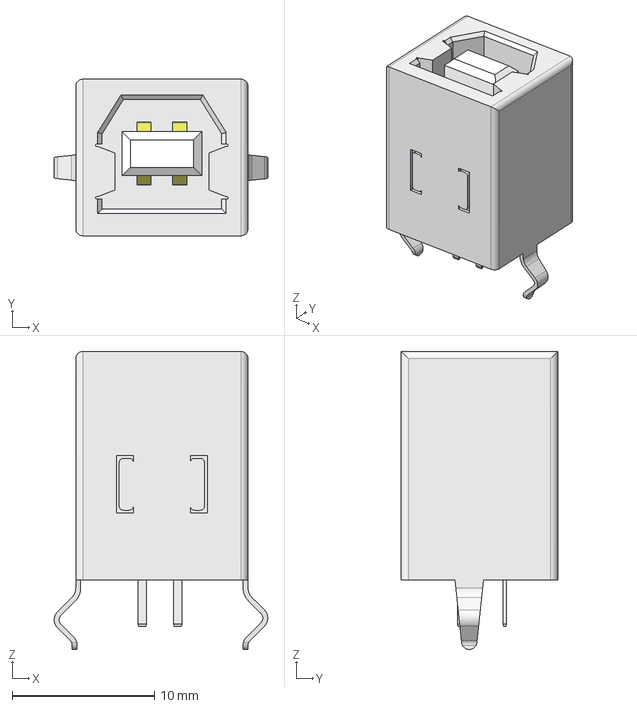
[picture p129: CAD file, 2018-07-28]
3d/2411_01_USB-VERTICAL-C.step
15.0 x 11.0 x 20.9 mm
