cGooding66/cLib/3d/MSOP8.step

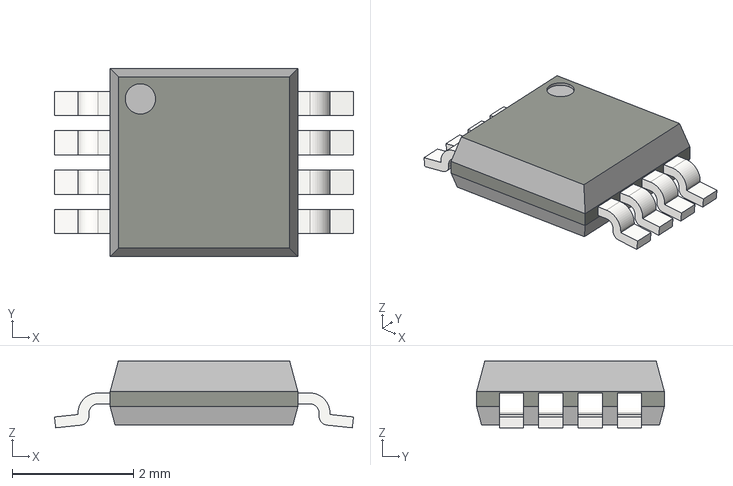
[picture p130: CAD file, 2018-07-28]
3d/MSOP8.step
4.94 x 3.10 x 1.10 mm
