cGooding66/cLib/3d/SOIC16.step

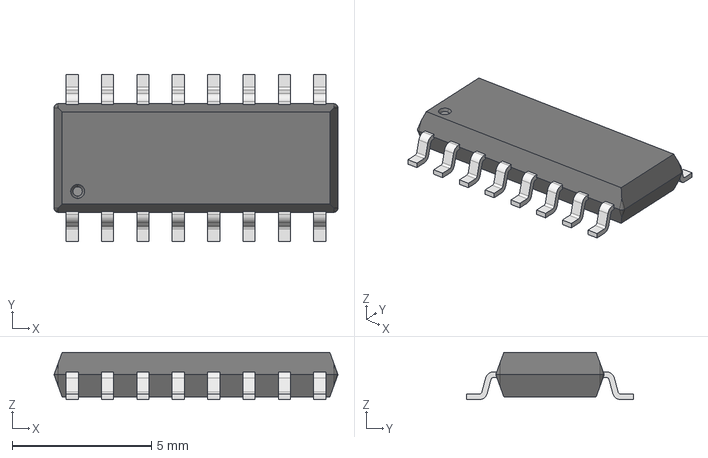
[picture p131: CAD file, 2018-07-28]
3d/SOIC16.step
10.2 x 6.00 x 1.70 mm
