cGooding66/cLib/3d/A759MW157M1JAAE048.step

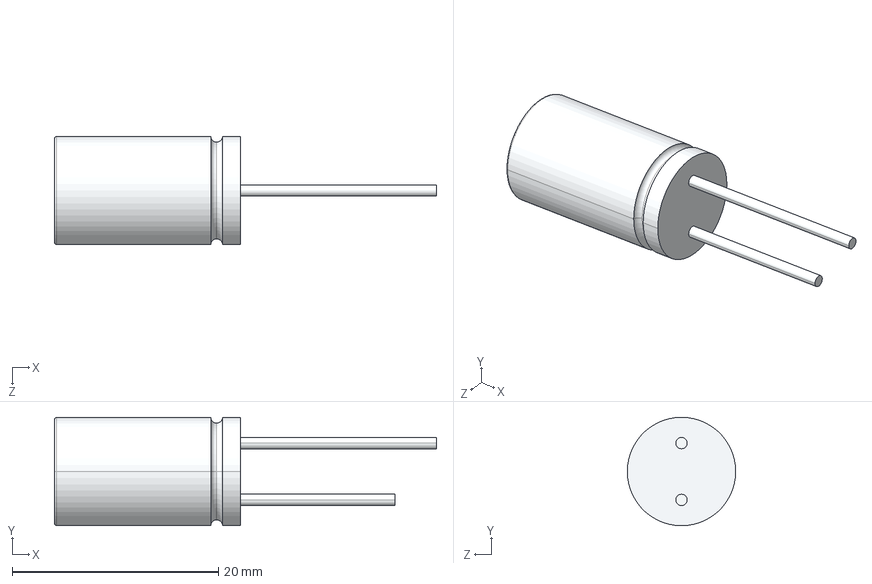
[picture p132: CAD file, 2018-07-28]
3d/A759MW157M1JAAE048.step
37.0 x 10.5 x 10.5 mm
