cGooding66/cLib/3d/SOP-4.step

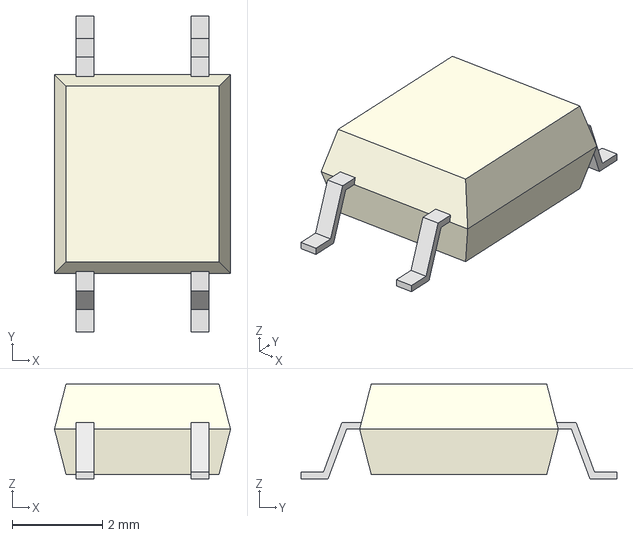
[picture p133: CAD file, 2018-07-28]
3d/SOP-4.step
3.90 x 7.00 x 2.10 mm
