cGooding66/cLib/3d/DFN6(2X2).step

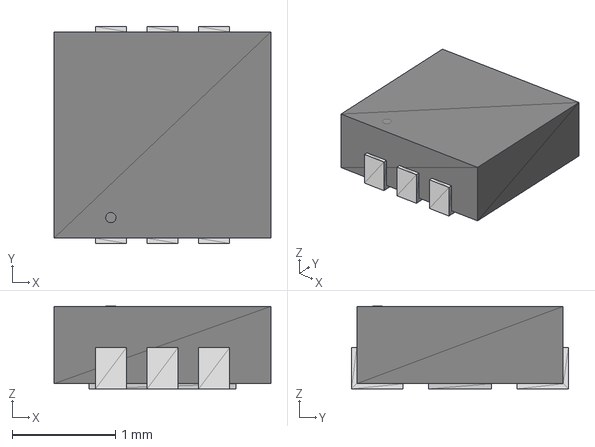
[picture p134: CAD file, 2018-07-28]
3d/DFN6(2X2).step
2.10 x 2.10 x 0.803 mm
