cGooding66/cLib/3d/M12A-12PFFP-SF8001_SW0001.step

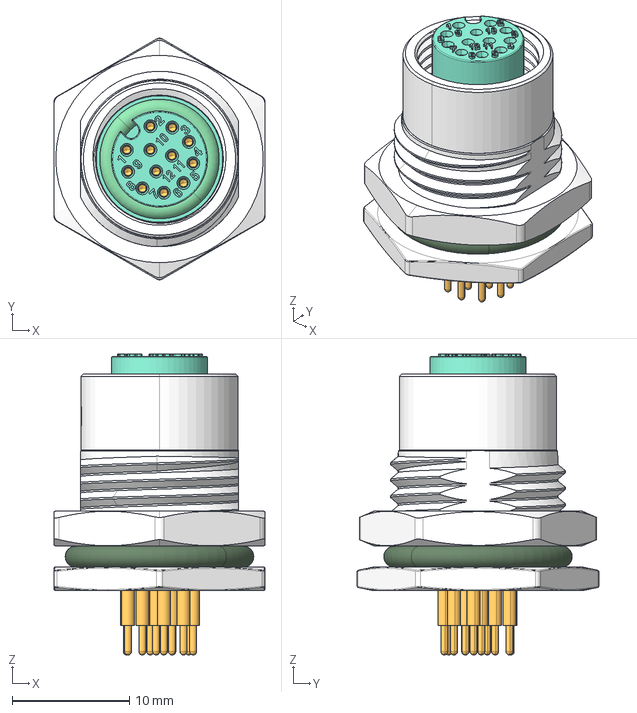
[picture p135: CAD file, 2018-07-28]
3d/M12A-12PFFP-SF8001_SW0001.step
18.0 x 20.6 x 25.7 mm
