cGooding66/cLib/3d/msop-12.step

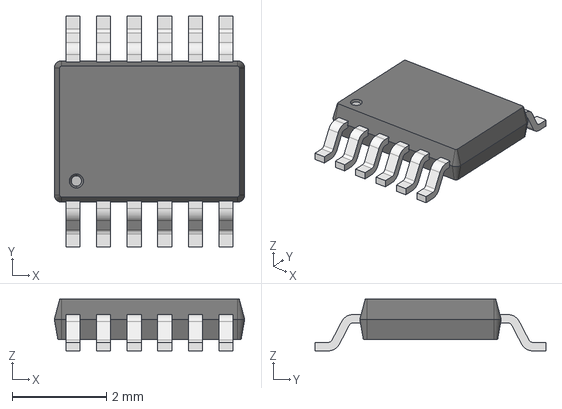
[picture p136: CAD file, 2018-07-28]
3d/msop-12.step
4.04 x 4.90 x 1.10 mm
