cGooding66/cLib/3d/mc_1.5-9-g-3.5.step

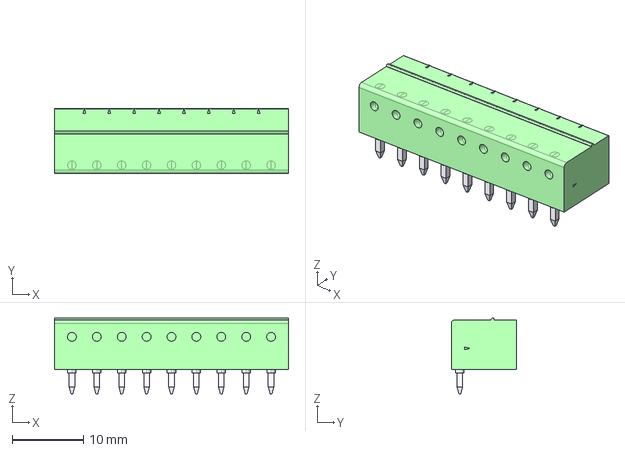
[picture p137: CAD file, 2018-07-28]
3d/mc_1.5-9-g-3.5.step
32.9 x 9.20 x 10.7 mm
