cGooding66/cLib/(list of files, cad)

Other CAD files:
Freecad/Ferrule-Yellow.step
Freecad/Ferrule-Black.step
Freecad/Ferrule-Green.step
3d/Red-LED-Osram-PLCC4.step
3d/TSSOP20.step
3d/CAR_KP_KK_D8_5L9S4F1_1_cp.step
3d/QFN48_7x7.step
3d/MSS1P5.step
3d/C_0805.stp
3d/Phoenix-2278377.step
3d/Amber-LED-Osram-PLCC4.step
3d/User Library-sot235.stl
3d/SOT23-3.step
3d/PowerPAK SO-8 (S).step
3d/0476030001-Molex-SIM.step
3d/2278364.step
3d/2278377.stp
3d/25136NAH.step
3d/38700-6104.step
3d/38700-61048.step
3d/418217270902A.step
3d/43045-0614.step
3d/47352-1001.step
3d/503159-0600.step
3d/503159-0800.step
3d/5031750600.step
3d/53048-0310.step
3d/68930.step
3d/691321100002.step
3d/705530001.step
3d/705530006.step
3d/73100-0114.step
3d/732511150.step
3d/744235110.step
3d/750313445.step
3d/76030001_molex-SIM.step
3d/91228-3002 .step
3d/B4B-PH-K-S.stl
3d/B8B-PH-K-S (2).STEP
3d/C-0402.step
3d/DO214AC.step
3d/Diode_SMC.step
3d/HS_LC-H-D2_R2XC1-2.54_H.Select_00821945.step
3d/MCO_1_5_4-G1R_3_5_H.Select__00452073.step
3d/MW-06-03-G-D-185-075-A.stl
3d/Molex_43045_0621_cp.step
3d/Molex_502584_0860.step
3d/Programmer_Tray_Without_PCB.stl
3d/QFN16.step
3d/QFN48.step
3d/RED-LED.stp
3d/SC70-5-DCK.step
3d/SFM_105_02_L_D_A.step
3d/SOIC8.step
3d/SOT223-3.step
3d/SOT_23_6_PITCH_0_65.step
3d/SW3DPS-LED DIP 3MM-DEFAULT.STL
3d/TANT_CASEX.step
3d/TDFN6.step
3d/TDSON-8.step
3d/TLP214.step
3d/TSW-110-23-G-D.step
3d/User Library-B3B-PH-K-S(LF)(SN).stl
3d/User Library-DIOM8261X24.step
3d/User Library-ELLATV Choke coil.stl
3d/User Library-Fuse1210.stl
3d/User Library-Micro SD Holder 114-00841-68.STEP
3d/User Library-Part7.STL
3d/User Library-QFN28-0_5.STL
3d/User Library-SOT223-3.STL
3d/User Library-TDFN-EP-14.step
3d/User Library-res2512.STL
3d/User Library-res2512_body.step
3d/V70212MS02Q004.step
3d/WSON8_cp.step
3d/light guide.step
3d/mcv1.5-3-g_3.5.step
3d/mcv_1.5-2-gf-3.5.step
3d/mstbva_2.5-2-g-5.08.step
3d/neo.stl
3d/sod80c.step
Freecad/Amber-LED-Osram-PLCC4.stp
Freecad/Ferrule.igs
Freecad/Red-LED-OSRAM-PLCC4.fcstd
Freecad/Red-LED.stp
